ExquisiteCatBread/RatDistortion/README.md

# RatDistortion
Guitar pedal based on Proco RAT

See "Distortion pedal project documentation.pdf"

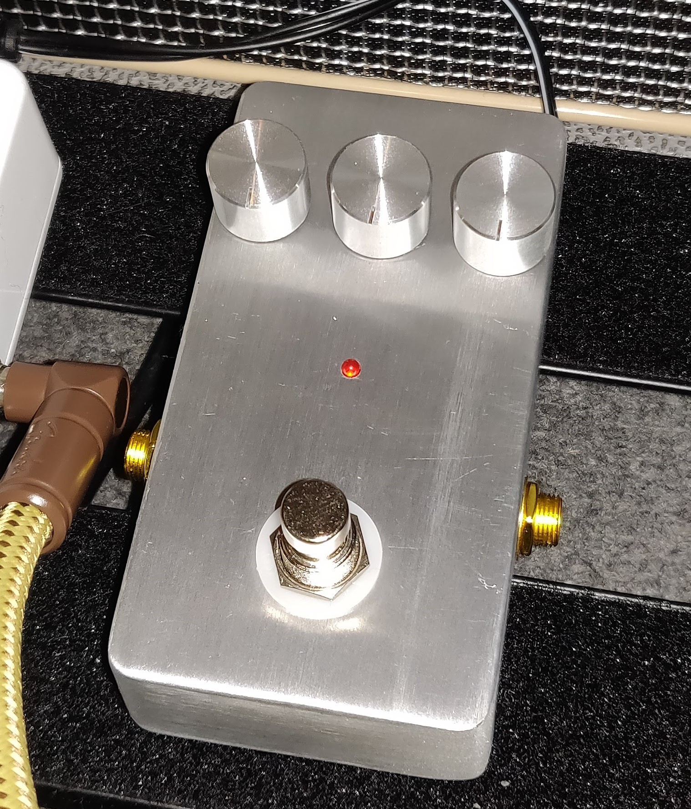
[picture p1: Pictures/Pedal.jpg]
RAT_distortion_pedal
