ExquisiteCatBread/RatDistortion/Pictures/3pdt layout (1).jpg

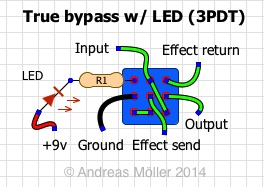
Pictures/3pdt layout (1).jpg
