ExquisiteCatBread/RatDistortion/Pictures/3pdt layout.png

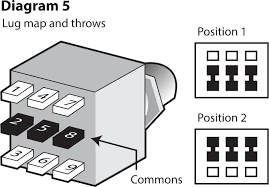
Pictures/3pdt layout.png
