ExquisiteCatBread/RatDistortion/Pictures/Drilling (1).jpg

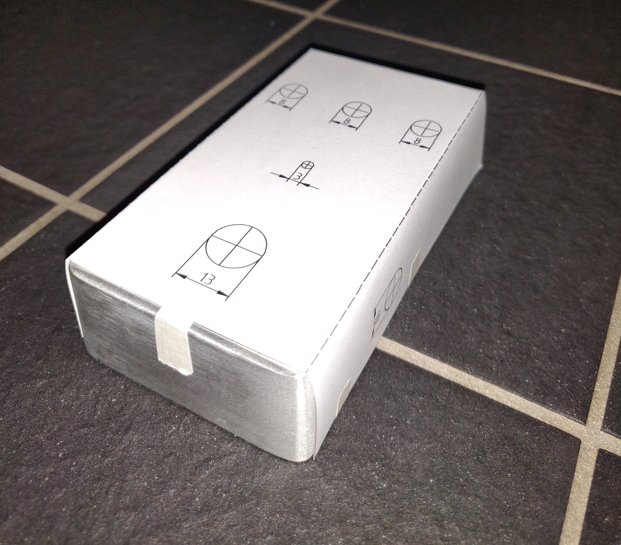
Pictures/Drilling (1).jpg
