ExquisiteCatBread/RatDistortion/Pictures/Drilling (2).jpg

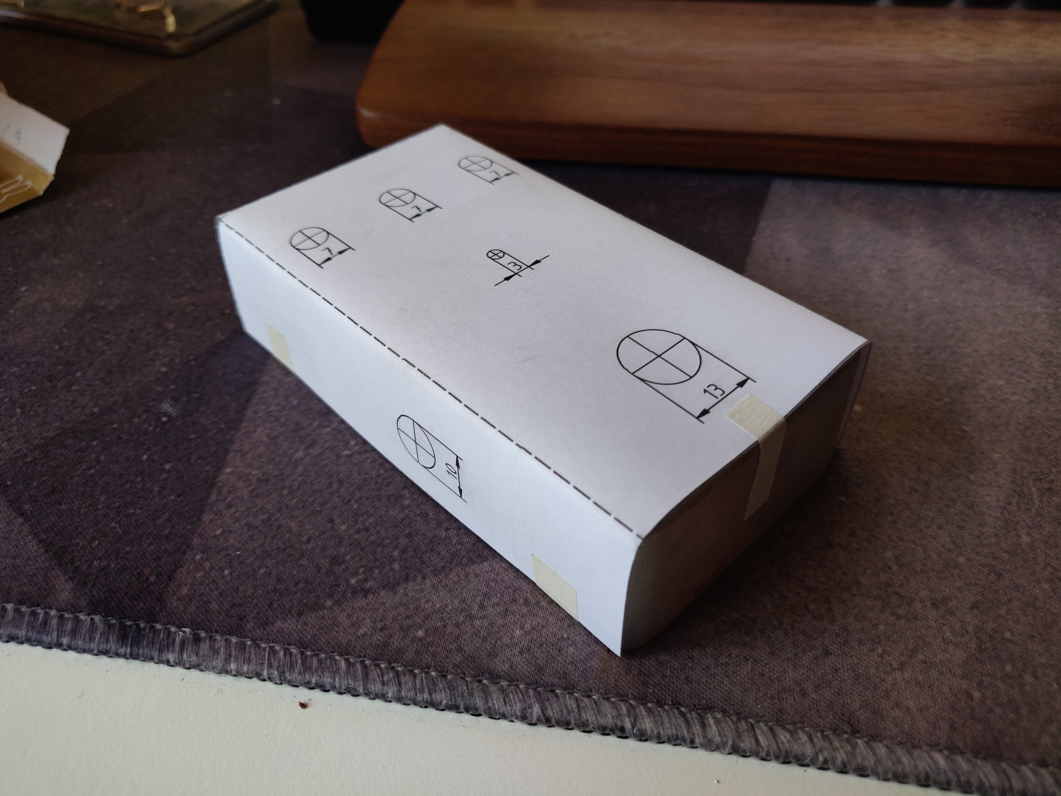
Pictures/Drilling (2).jpg
