ExquisiteCatBread/RatDistortion/Pictures/Drilling (3).jpg

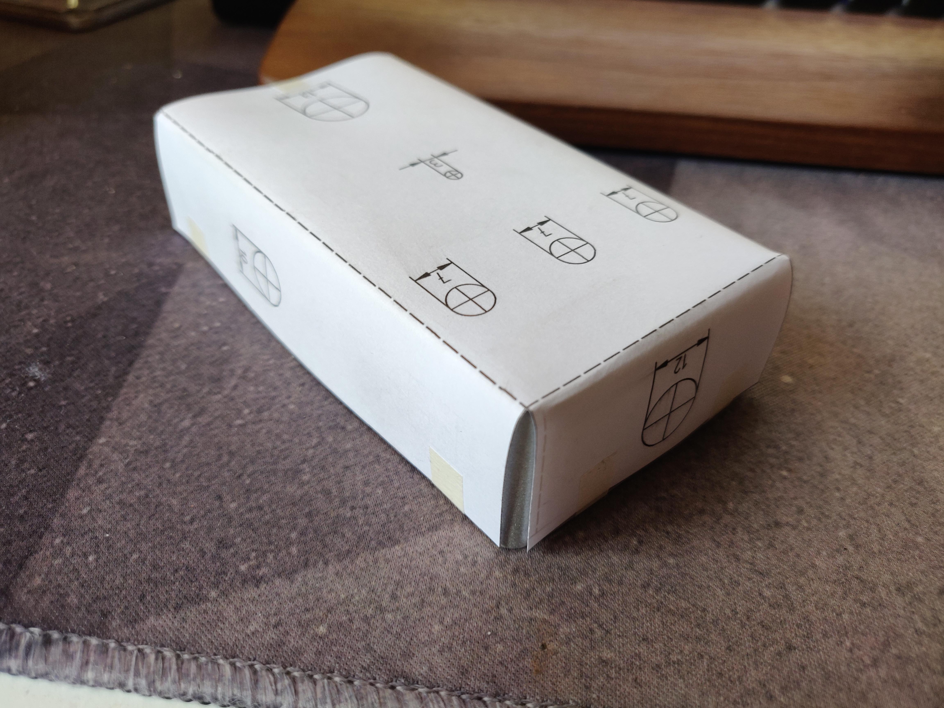
Pictures/Drilling (3).jpg
