ExquisiteCatBread/RatDistortion/Pictures/Drilling (4).jpg

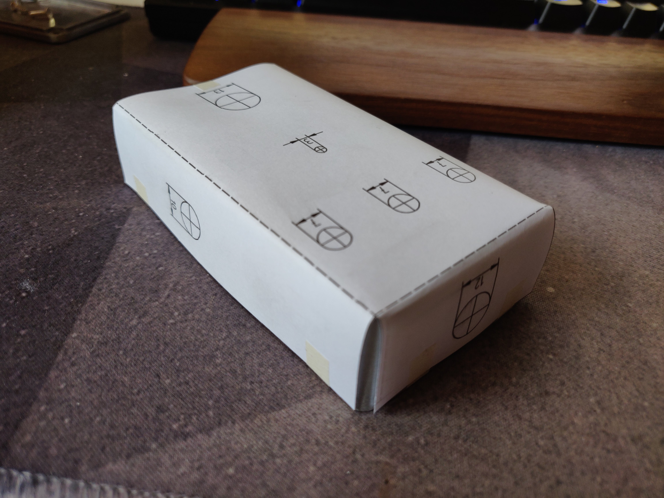
Pictures/Drilling (4).jpg
