ExquisiteCatBread/RatDistortion/Pictures/Drilling (5).jpg

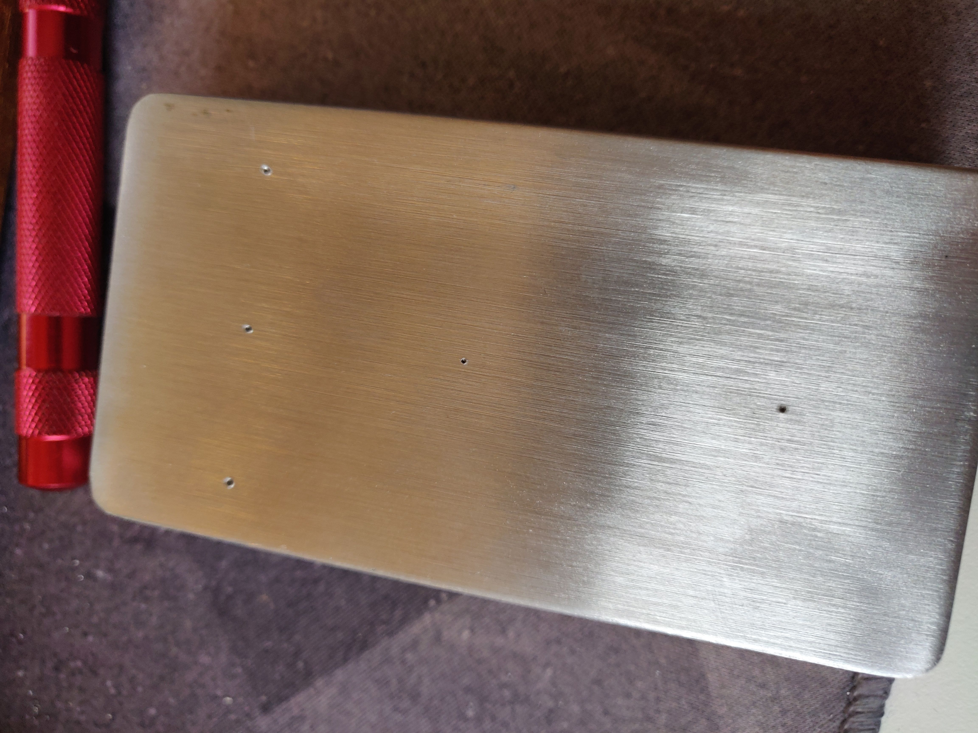
Pictures/Drilling (5).jpg
