ExquisiteCatBread/RatDistortion/Pictures/Drilling (6).jpg

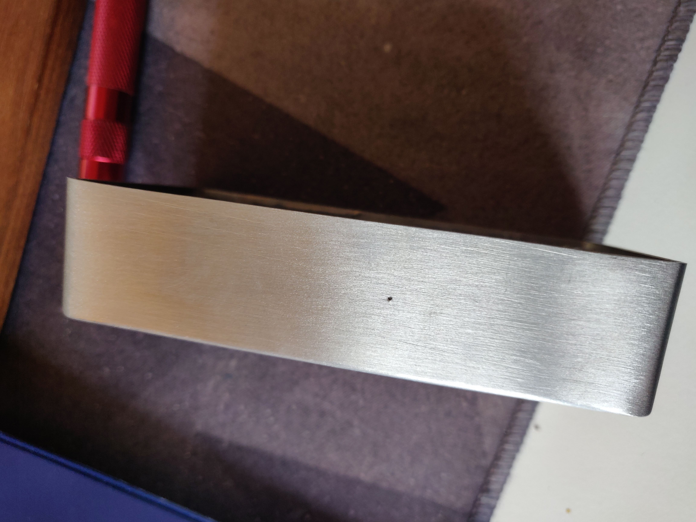
Pictures/Drilling (6).jpg
