ExquisiteCatBread/RatDistortion/Pictures/Drilling (7).jpg

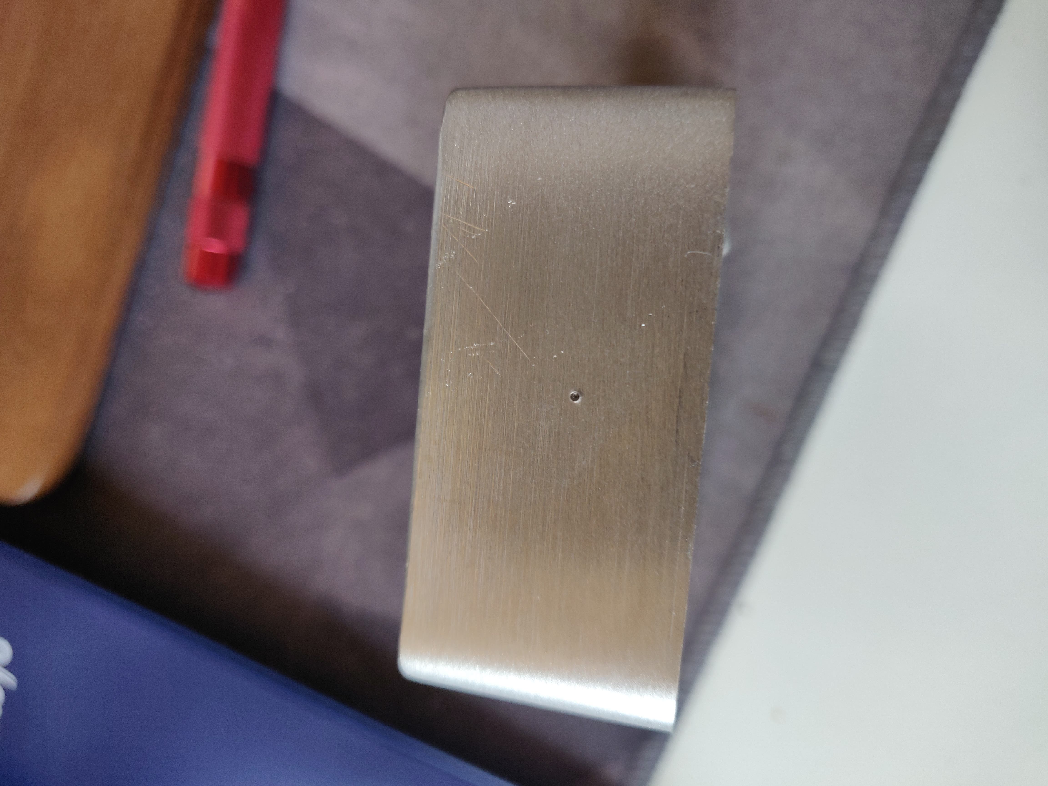
Pictures/Drilling (7).jpg
