ExquisiteCatBread/RatDistortion/Pictures/Drilling (8).jpg

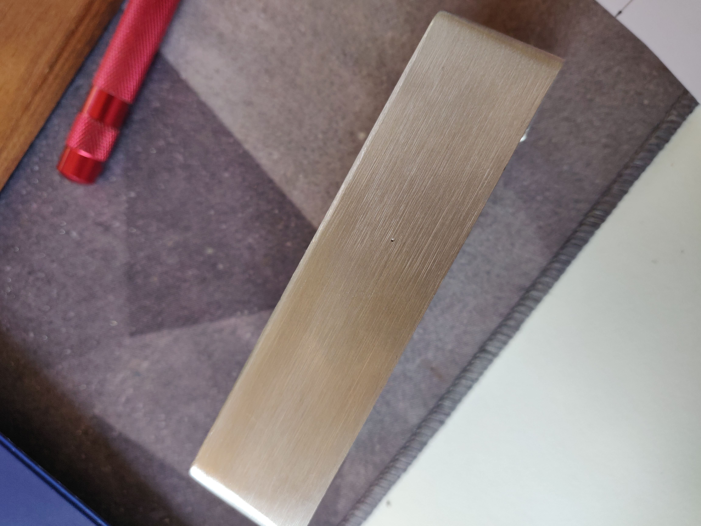
Pictures/Drilling (8).jpg
