ExquisiteCatBread/RatDistortion/Pictures/Drilling (9).jpg

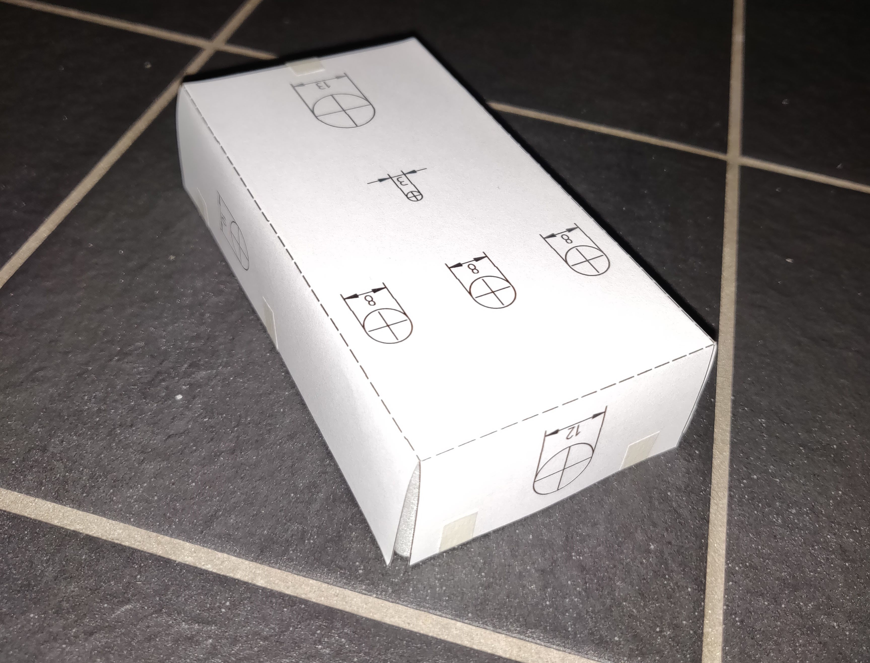
Pictures/Drilling (9).jpg
