ExquisiteCatBread/RatDistortion/Pictures/Drilling (10).jpg

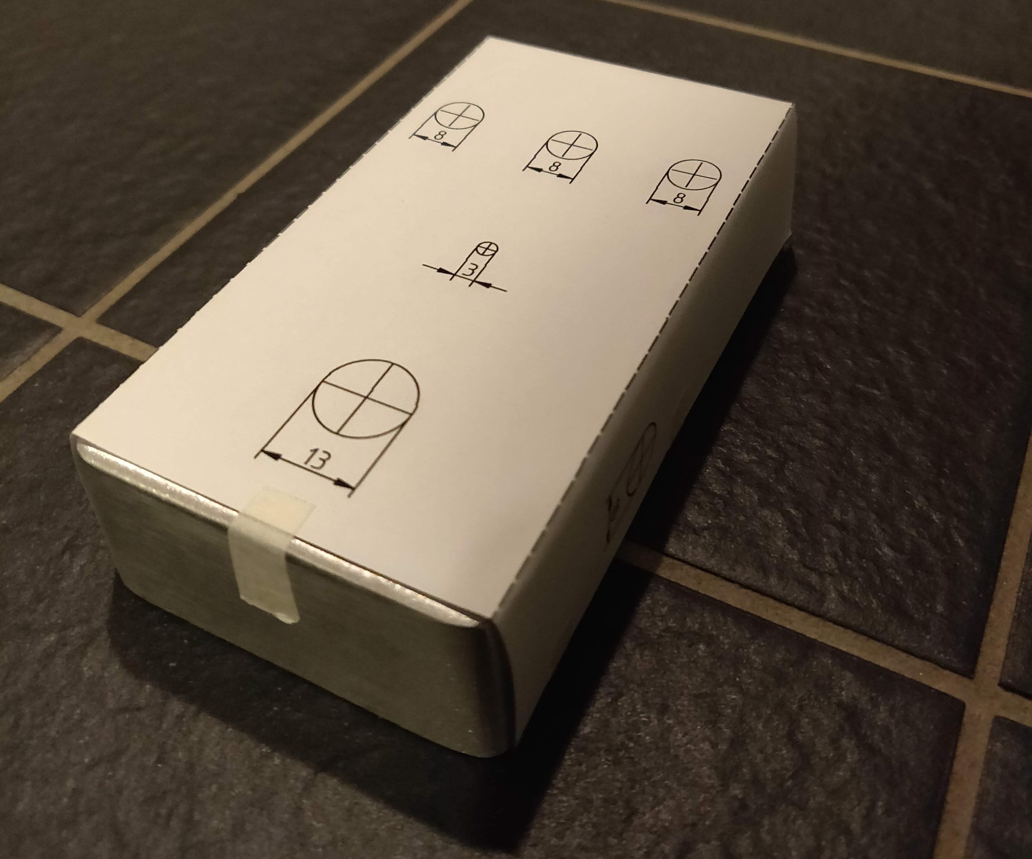
Pictures/Drilling (10).jpg
