ExquisiteCatBread/RatDistortion/Pictures/Drilling (11).jpg

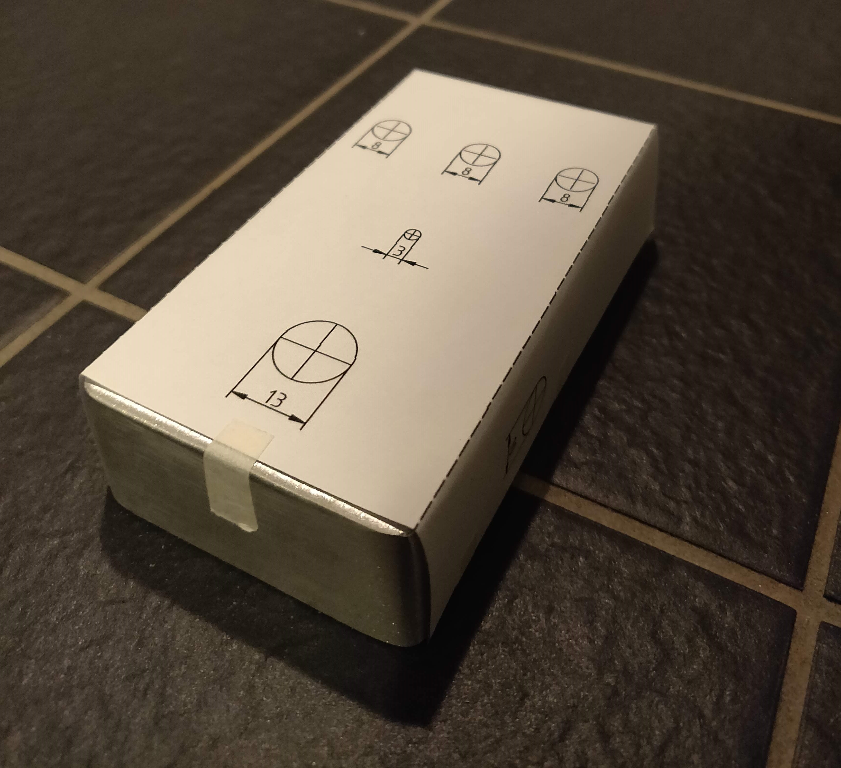
Pictures/Drilling (11).jpg
