ExquisiteCatBread/RatDistortion/Pictures/Fake JFET analysis.jpg

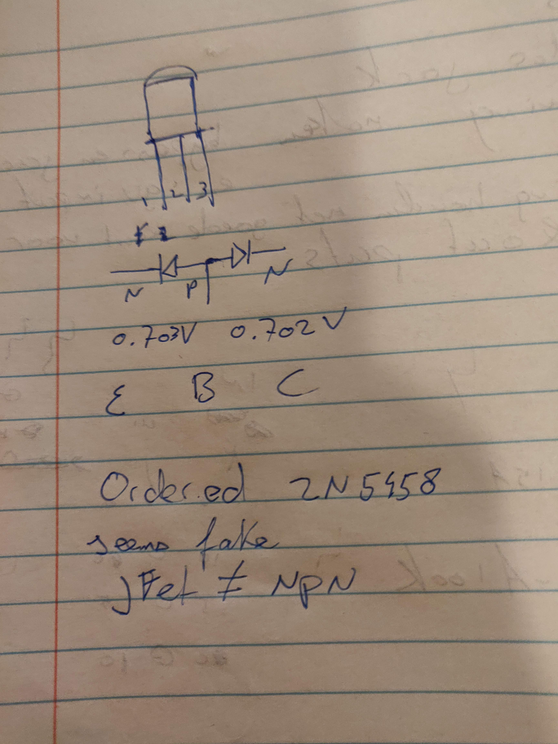
Pictures/Fake JFET analysis.jpg
