ExquisiteCatBread/RatDistortion/Pictures/Inside.jpg

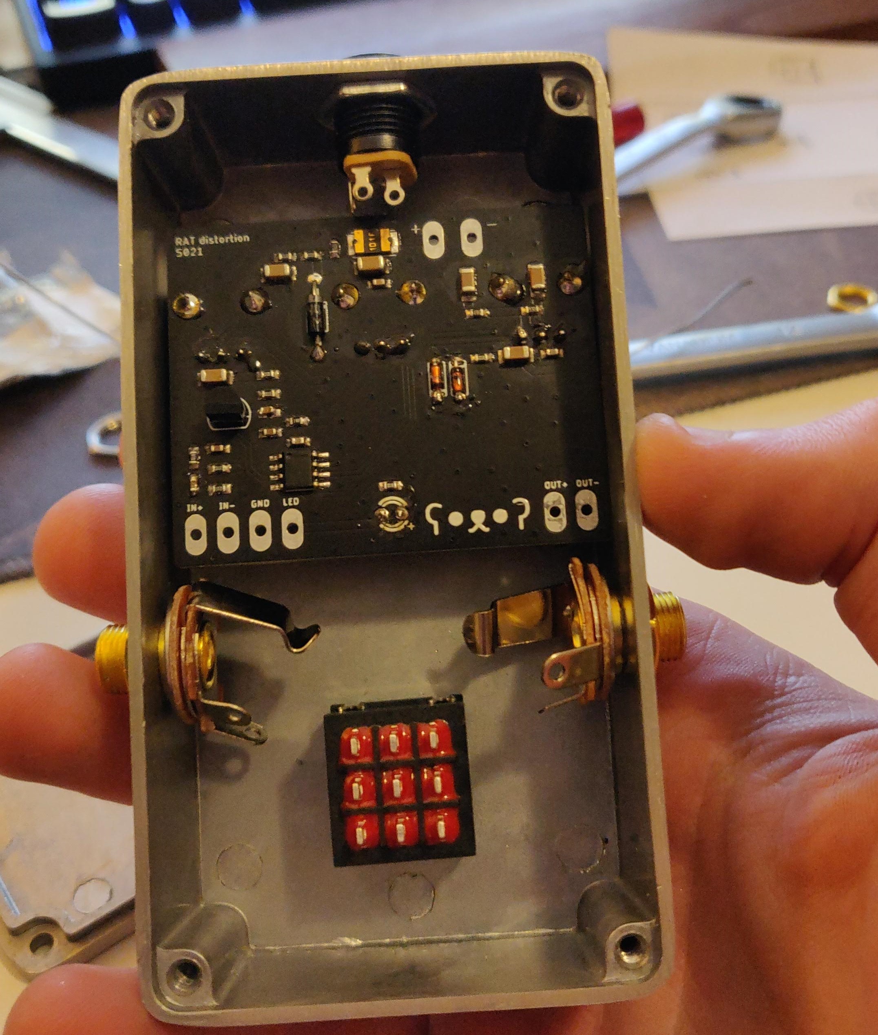
Pictures/Inside.jpg
