ExquisiteCatBread/RatDistortion/Pictures/Laser engraving (1).jpg

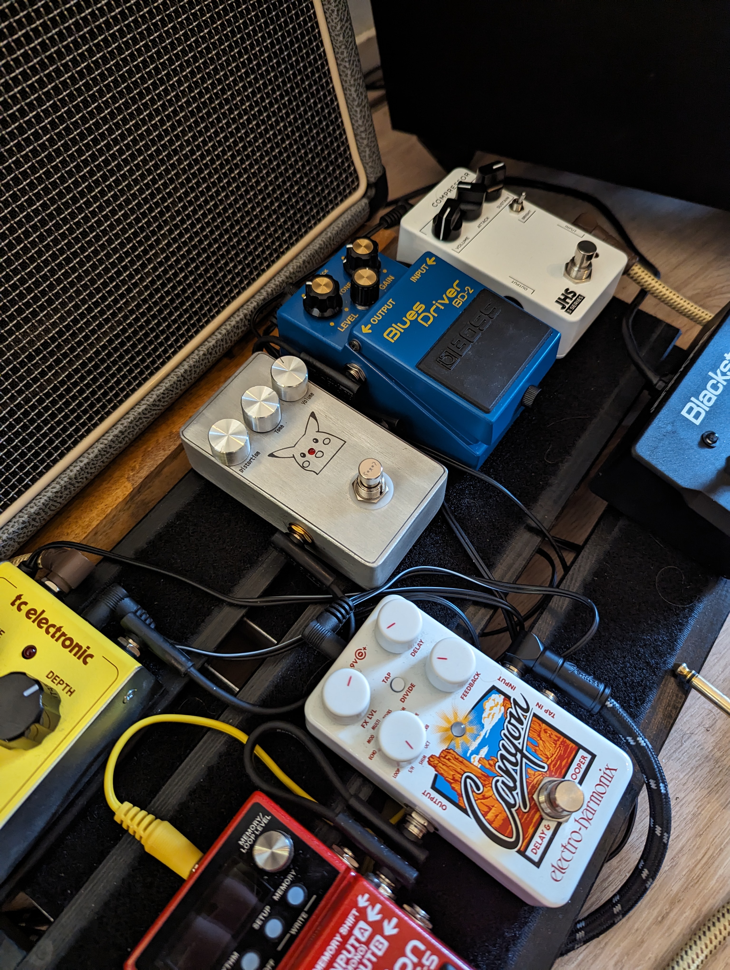
Pictures/Laser engraving (1).jpg
