ExquisiteCatBread/RatDistortion/Pictures/Laser engraving (2).jpg

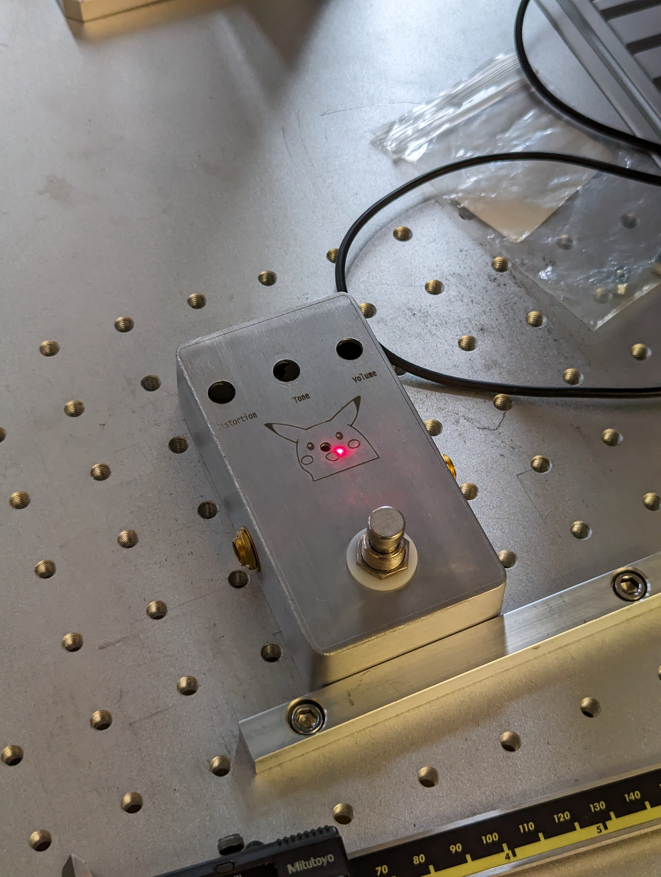
Pictures/Laser engraving (2).jpg
