ExquisiteCatBread/RatDistortion/Pictures/Laser engraving (3).jpg

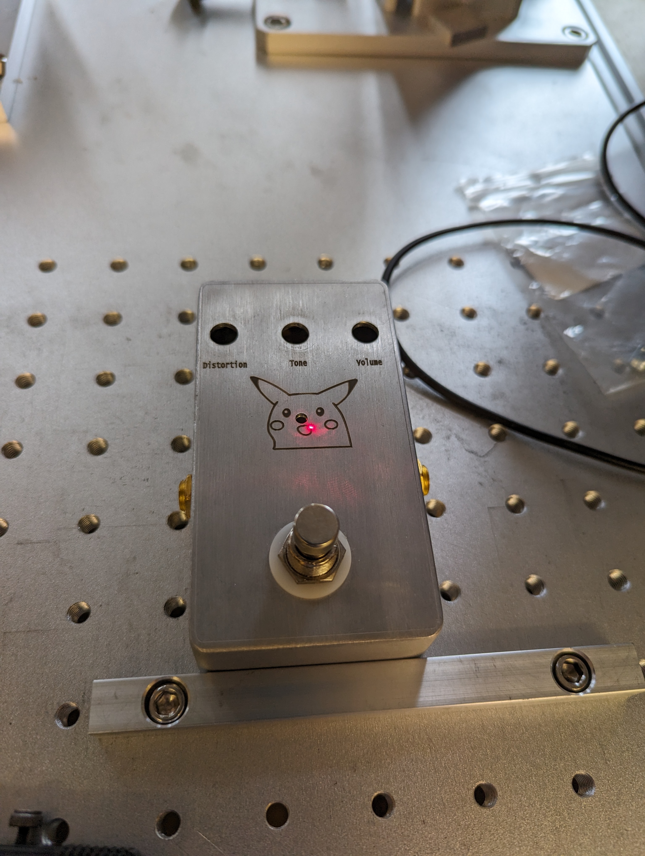
Pictures/Laser engraving (3).jpg
