ExquisiteCatBread/RatDistortion/Pictures/Laser engraving (4).jpg

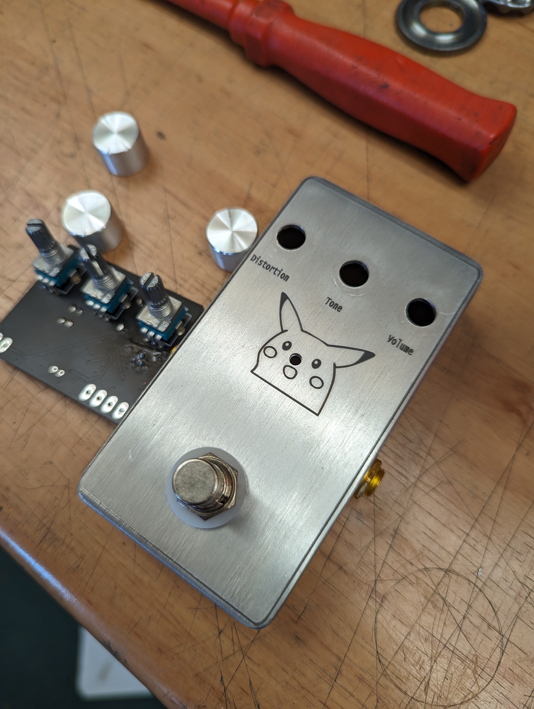
Pictures/Laser engraving (4).jpg
