ExquisiteCatBread/RatDistortion/Pictures/Laser engraving (5).jpg

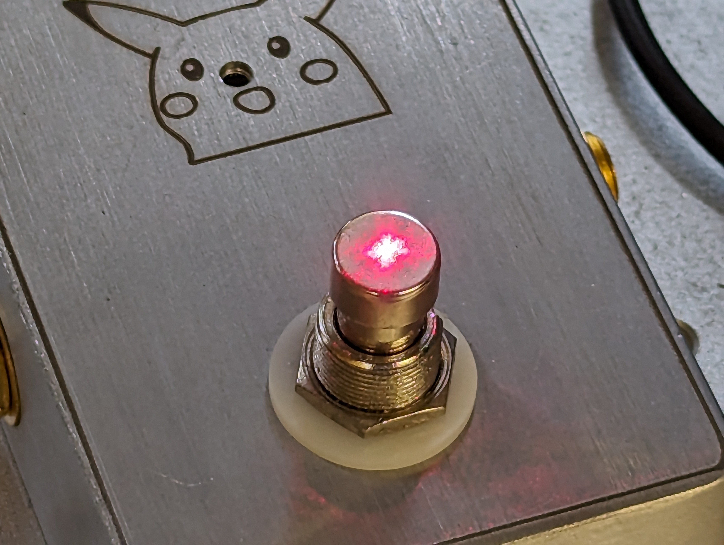
Pictures/Laser engraving (5).jpg
