ExquisiteCatBread/RatDistortion/Pictures/Laser engraving (6).jpg

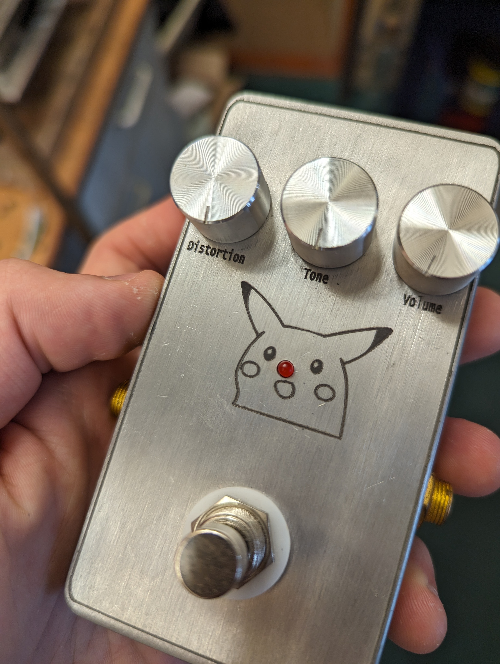
Pictures/Laser engraving (6).jpg
