ExquisiteCatBread/RatDistortion/Pictures/Laser engraving (7).jpg

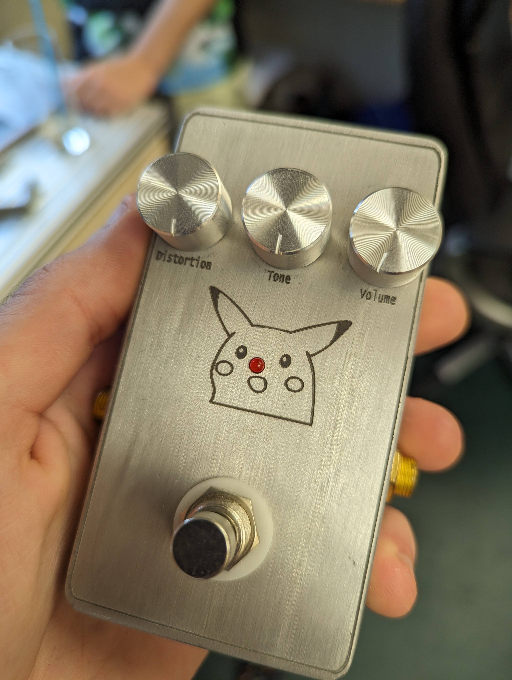
Pictures/Laser engraving (7).jpg
