ExquisiteCatBread/RatDistortion/Pictures/Laser engraving (8).jpg

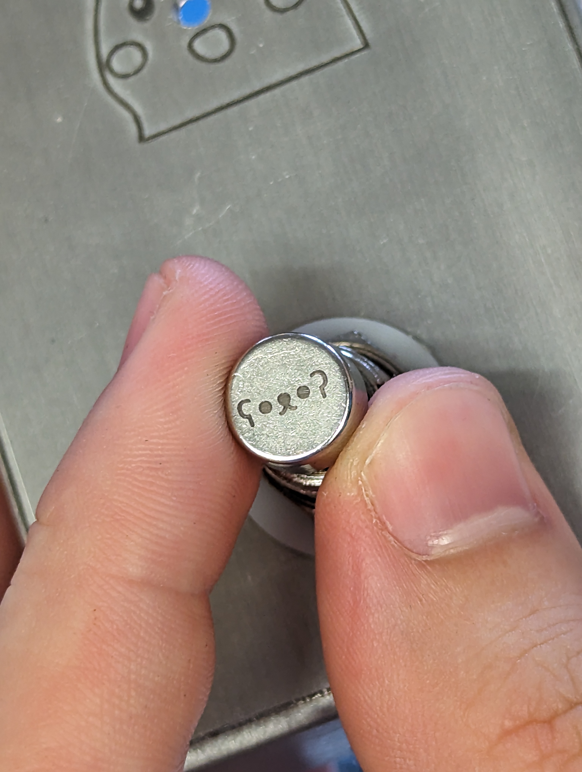
Pictures/Laser engraving (8).jpg
