ExquisiteCatBread/RatDistortion/Pictures/Laser engraving (9).jpg

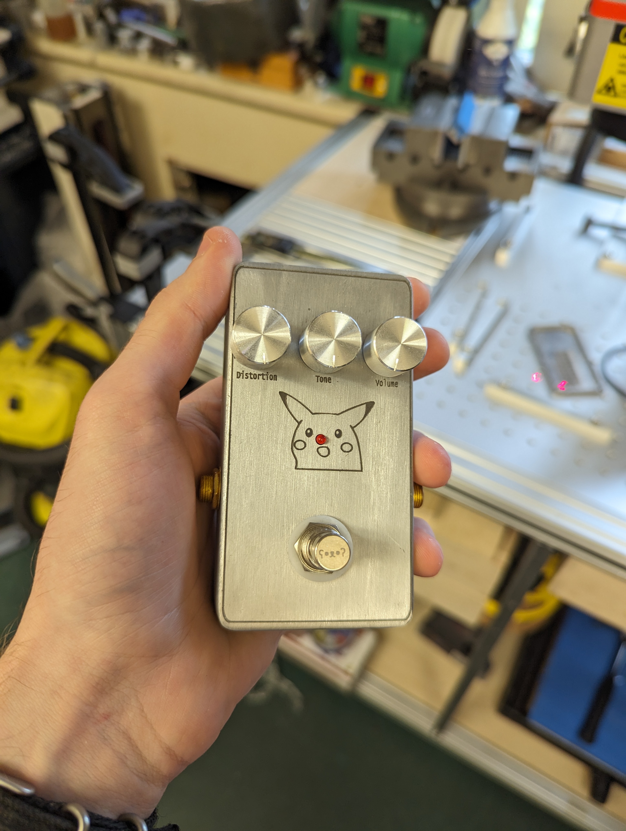
Pictures/Laser engraving (9).jpg
