ExquisiteCatBread/RatDistortion/Pictures/Laser engraving (10).jpg

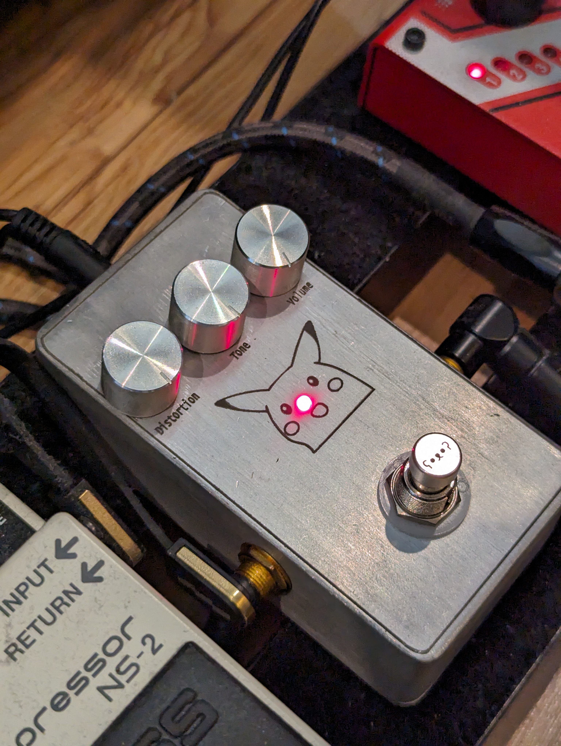
Pictures/Laser engraving (10).jpg
