ExquisiteCatBread/RatDistortion/Pictures/Laser engraving (11).jpg

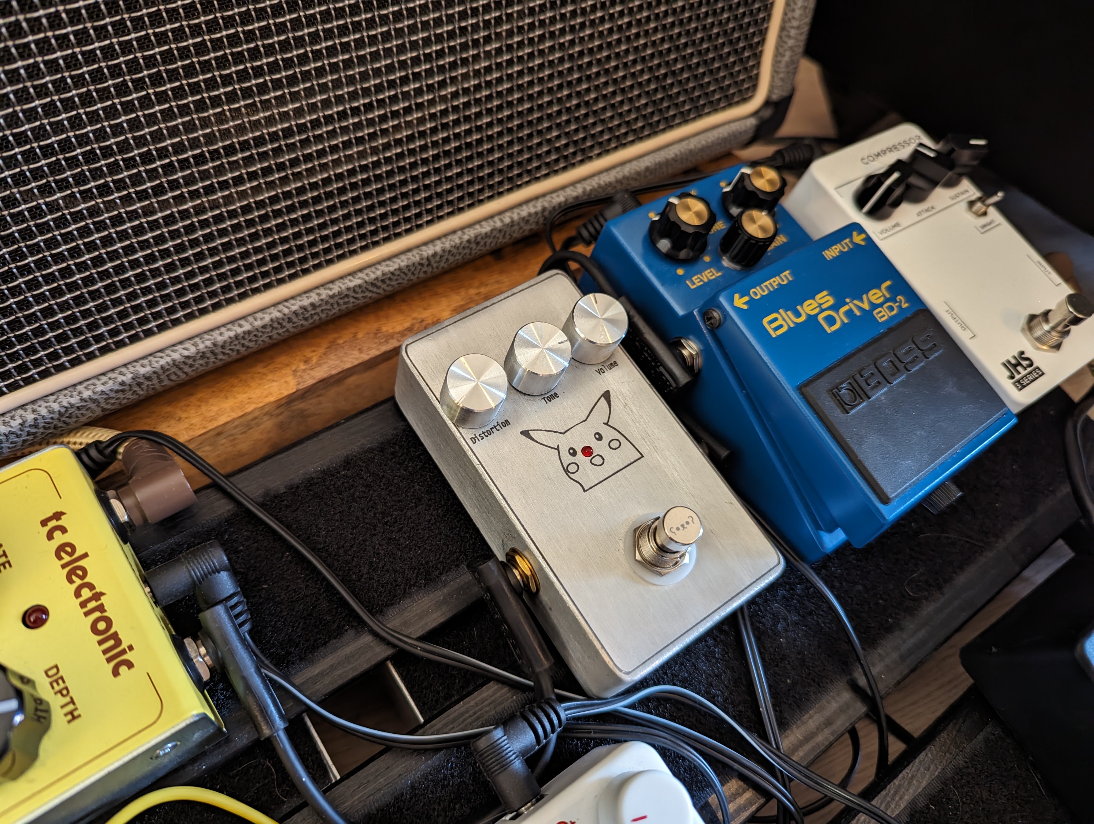
Pictures/Laser engraving (11).jpg
