ExquisiteCatBread/RatDistortion/Pictures/PCB (1).jpg

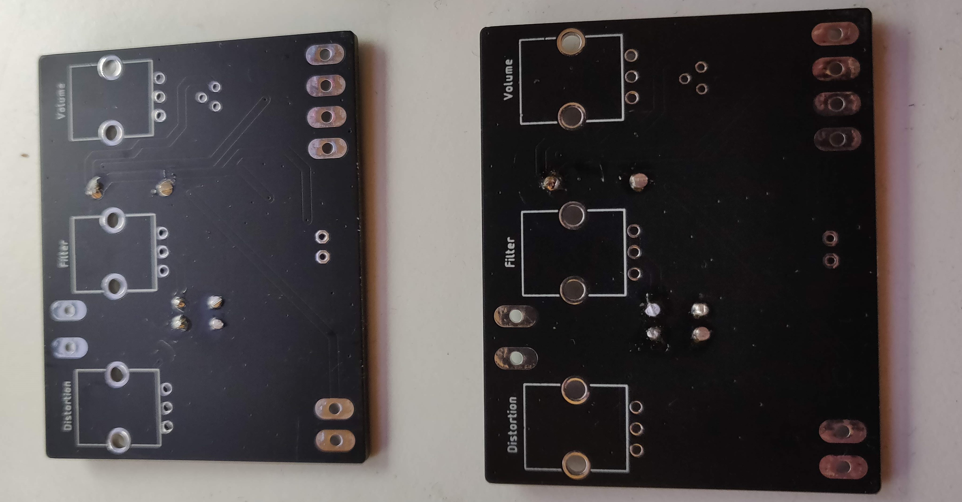
Pictures/PCB (1).jpg
