ExquisiteCatBread/RatDistortion/Pictures/PCB (2).jpg

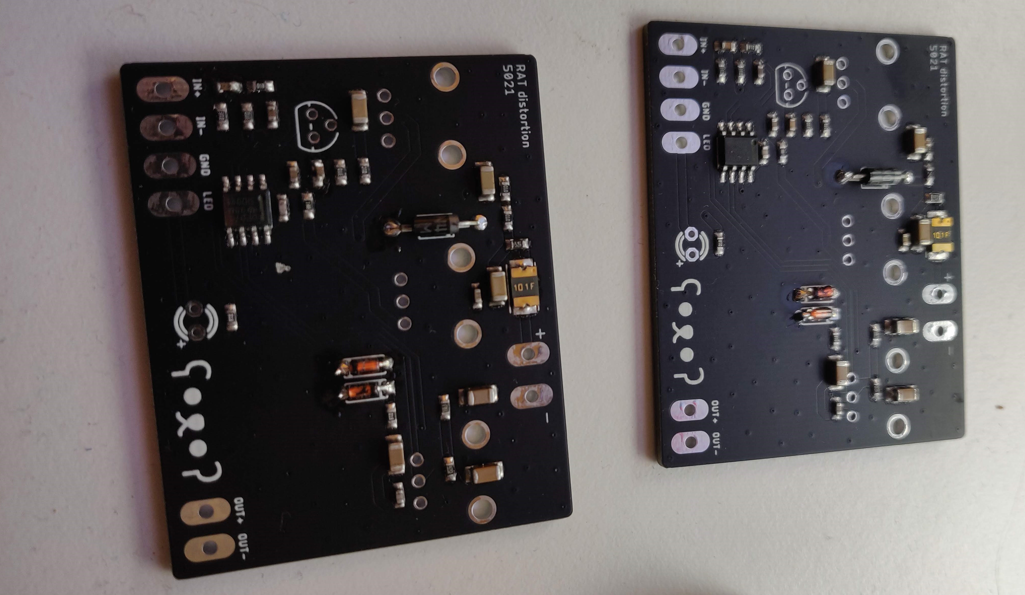
Pictures/PCB (2).jpg
