ExquisiteCatBread/RatDistortion/Pictures/Pedal (1).jpg

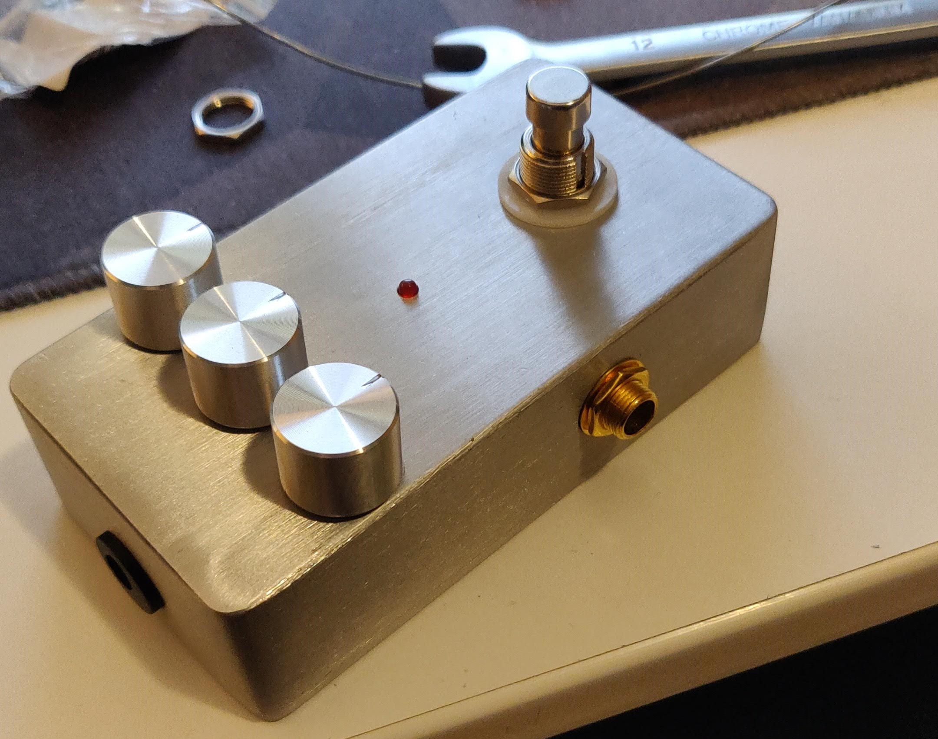
Pictures/Pedal (1).jpg
