ExquisiteCatBread/RatDistortion/Pictures/Pedal (3).jpg

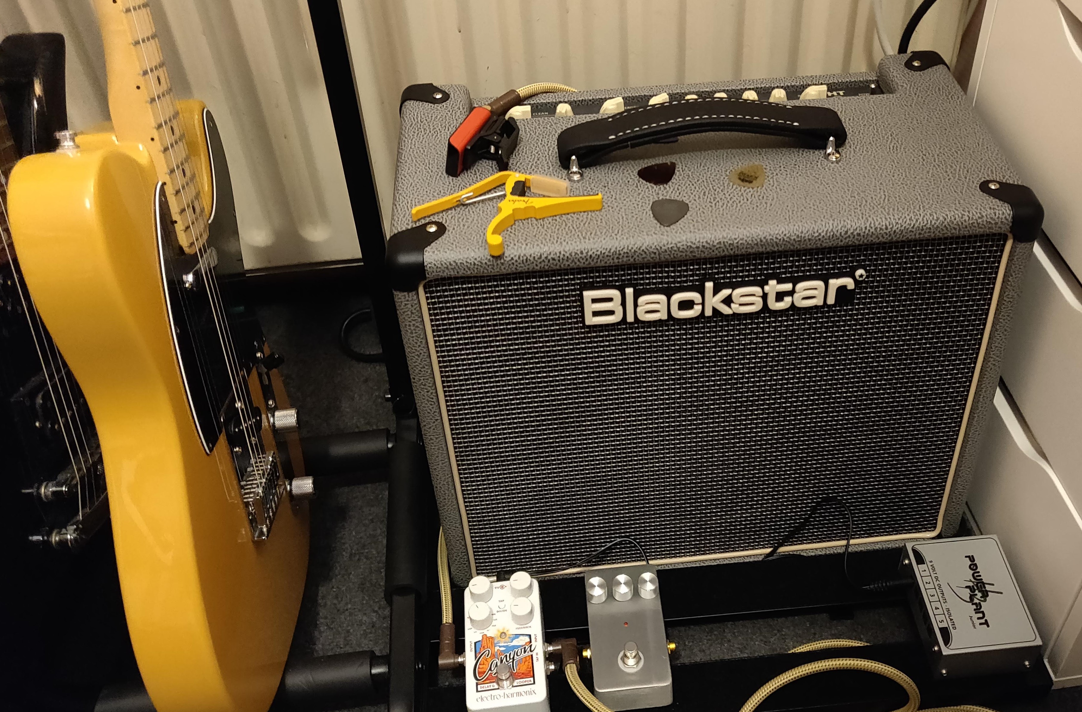
Pictures/Pedal (3).jpg
