ExquisiteCatBread/RatDistortion/Pictures/Pedal (4).jpg

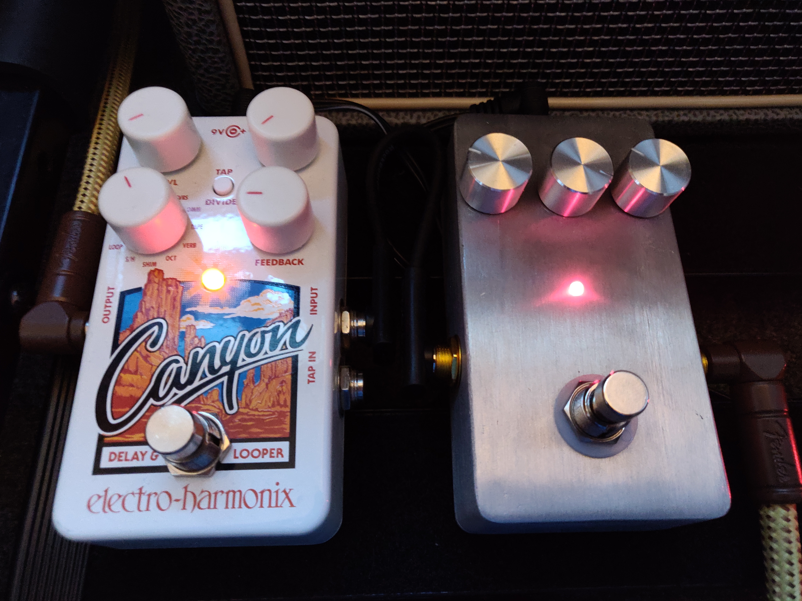
Pictures/Pedal (4).jpg
