ExquisiteCatBread/RatDistortion/Pictures/Pedal (5).jpg

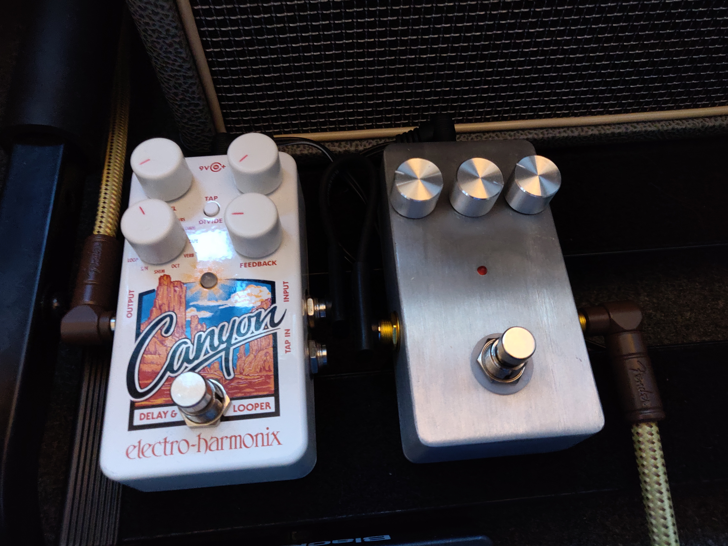
Pictures/Pedal (5).jpg
