ExquisiteCatBread/RatDistortion/Pictures/Used equipment.jpg

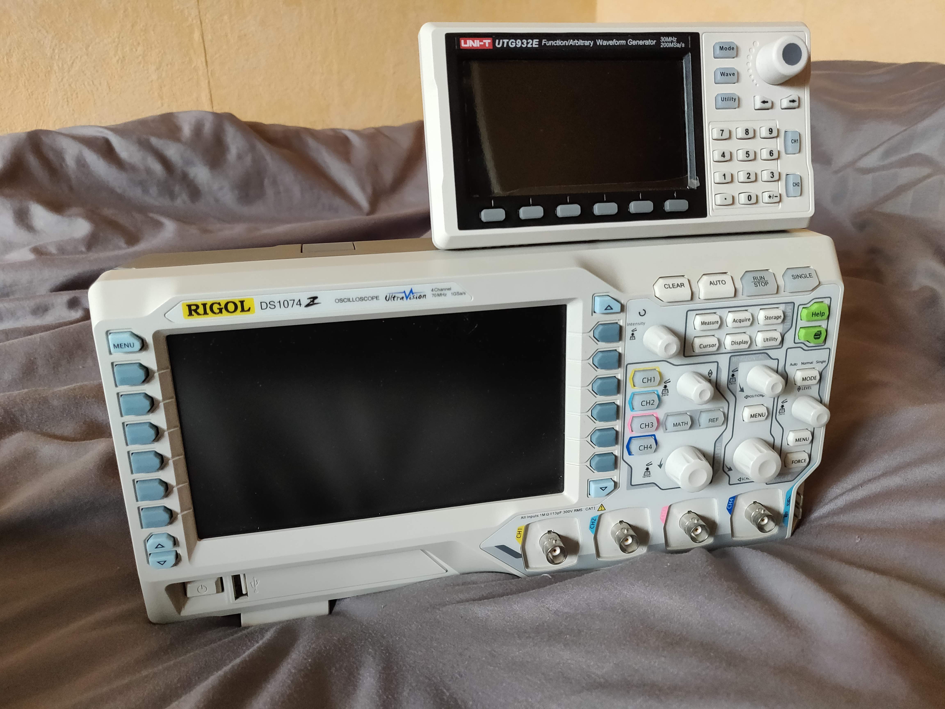
Pictures/Used equipment.jpg
