ExquisiteCatBread/RatDistortion/Drill template/RAT distortion drill template.dxf

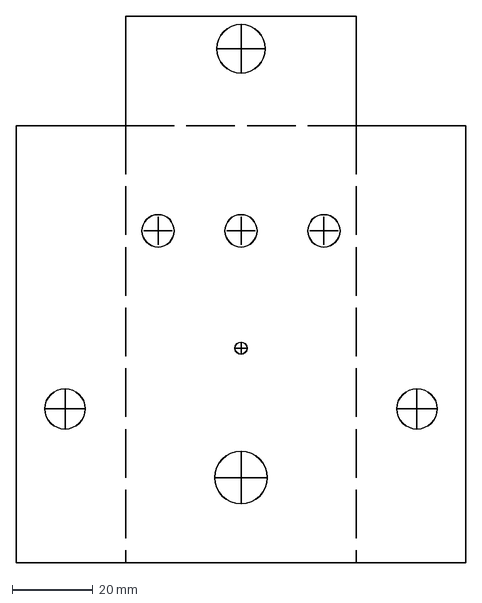
[picture p47: CAD file, 2021-12-30]
Drill template/RAT distortion drill template.dxf
111.0 x 135.0 mm
