ExquisiteCatBread/RatDistortion/Wiring PCB inside housing/Wires.png

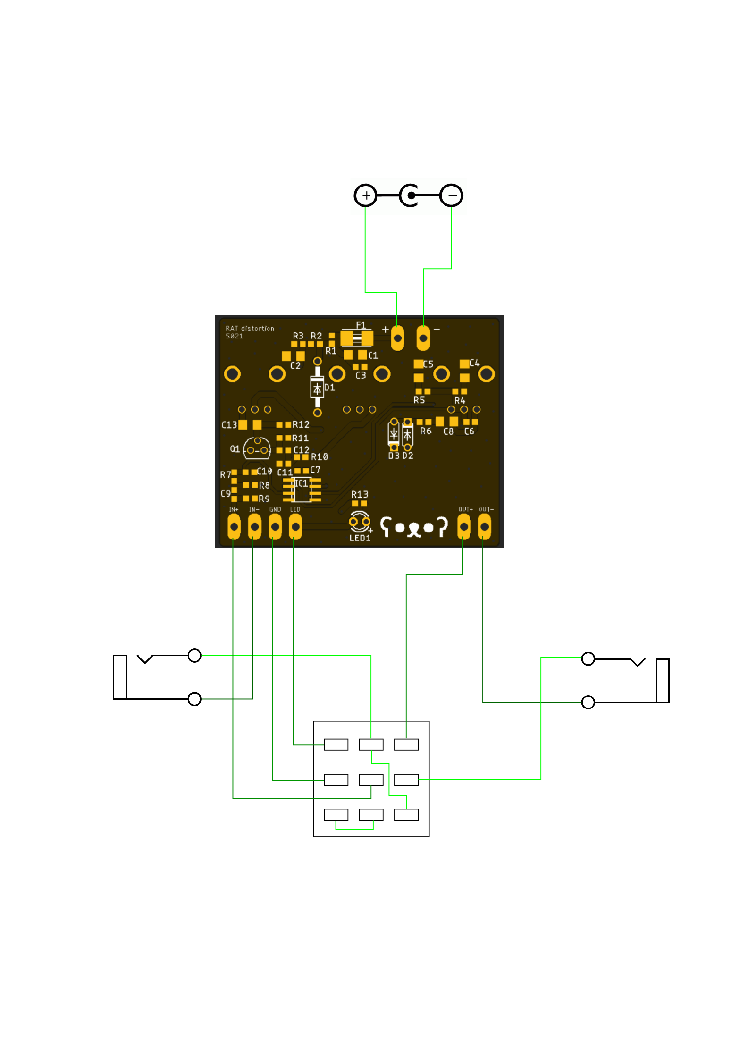
Wiring PCB inside housing/Wires.png
