ExquisiteCatBread/RatDistortion/Pictures/Testing/Filter 0p scope no load.png

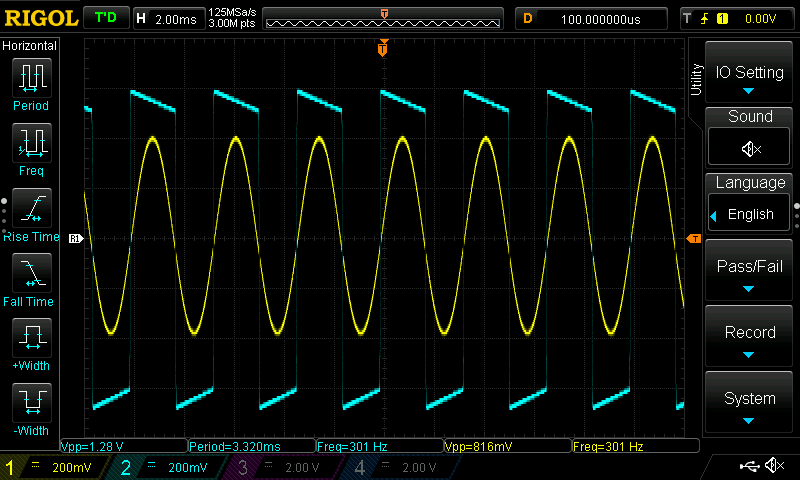
Pictures/Testing/Filter 0p scope no load.png
