ExquisiteCatBread/RatDistortion/Pictures/Testing/Filter 0p.JPG

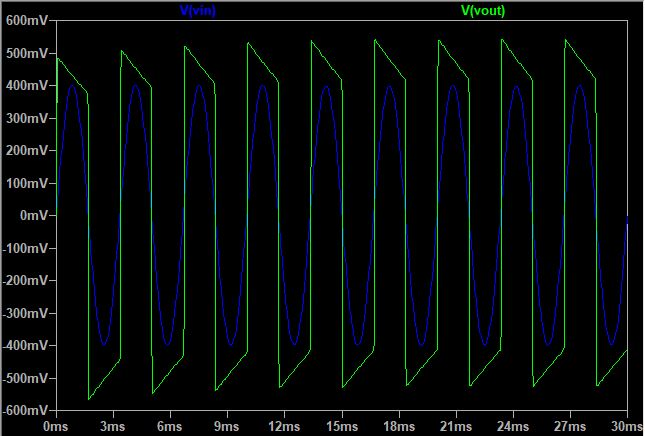
Pictures/Testing/Filter 0p.JPG
