ExquisiteCatBread/RatDistortion/Pictures/Testing/Filter 50p scope no load.png

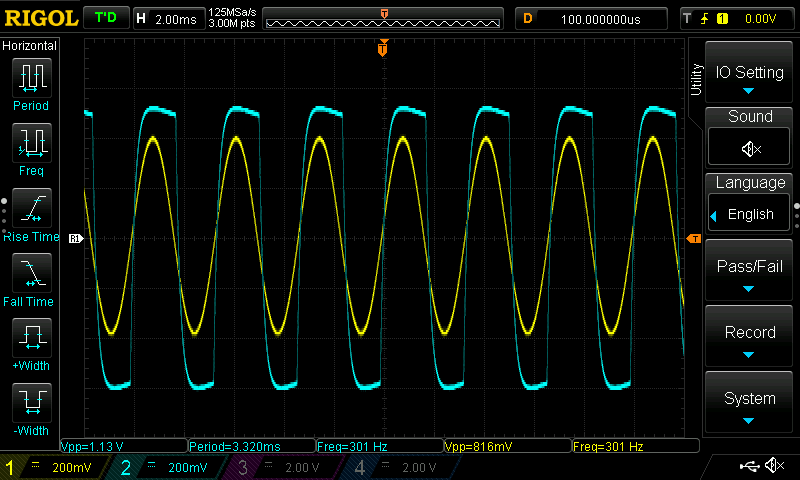
Pictures/Testing/Filter 50p scope no load.png
