ExquisiteCatBread/RatDistortion/Pictures/Testing/Filter 50p.JPG

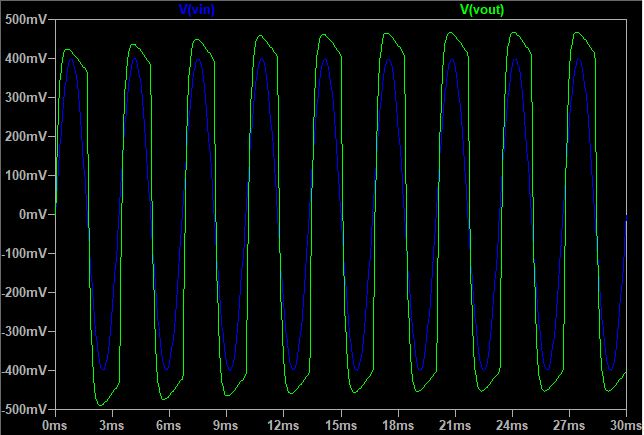
Pictures/Testing/Filter 50p.JPG
