ExquisiteCatBread/RatDistortion/Pictures/Testing/Filter 100p scope no load.png

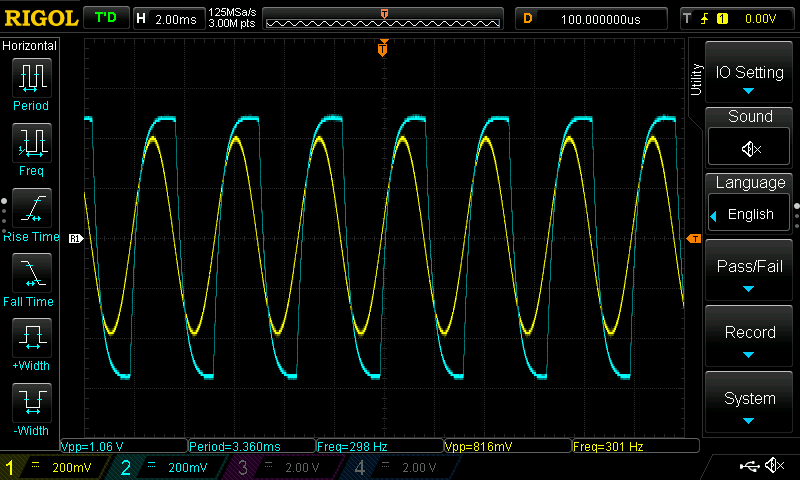
Pictures/Testing/Filter 100p scope no load.png
