ExquisiteCatBread/RatDistortion/Pictures/Testing/Filter 100p scope.png

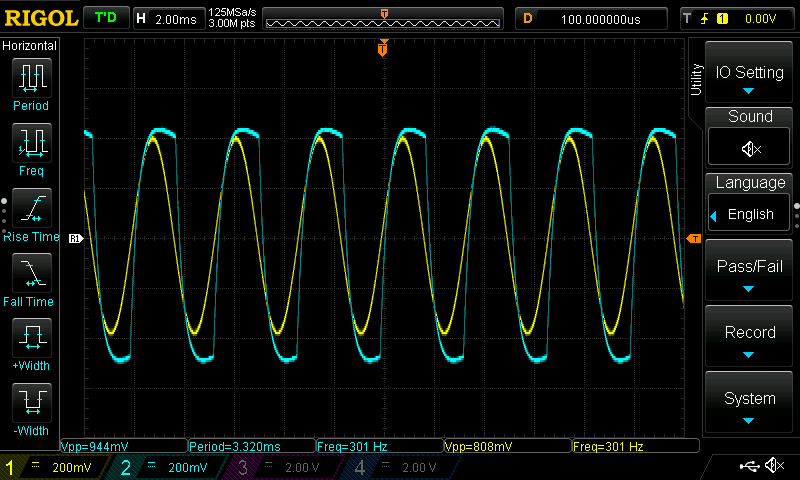
Pictures/Testing/Filter 100p scope.png
