ExquisiteCatBread/RatDistortion/Pictures/Testing/Filter 100p.JPG

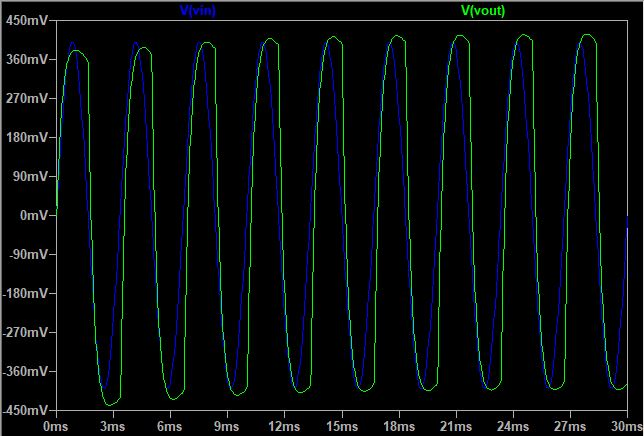
Pictures/Testing/Filter 100p.JPG
