ExquisiteCatBread/RatDistortion/Pictures/Testing/High dis 80hz scope no load.png

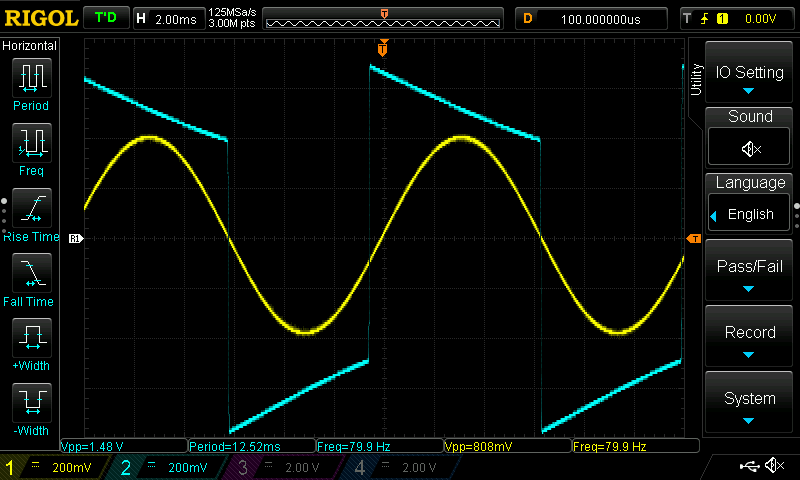
Pictures/Testing/High dis 80hz scope no load.png
