ExquisiteCatBread/RatDistortion/Pictures/Testing/High dis 80hz scope.png

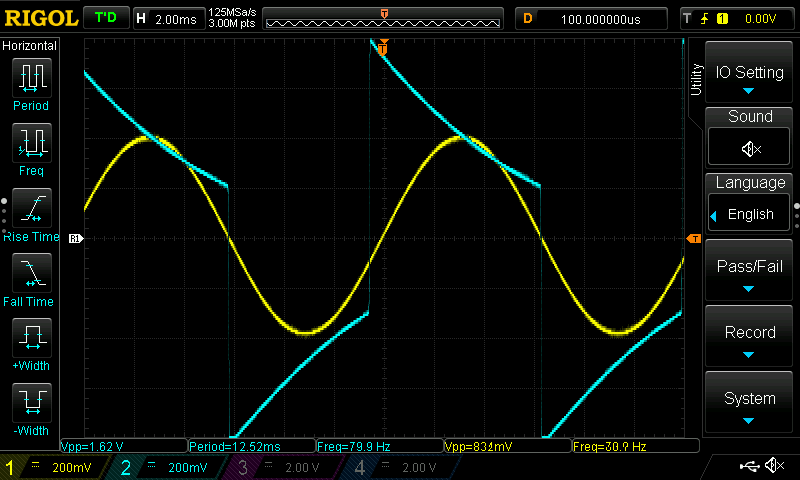
Pictures/Testing/High dis 80hz scope.png
