ExquisiteCatBread/RatDistortion/Pictures/Testing/High dis 80hz.JPG

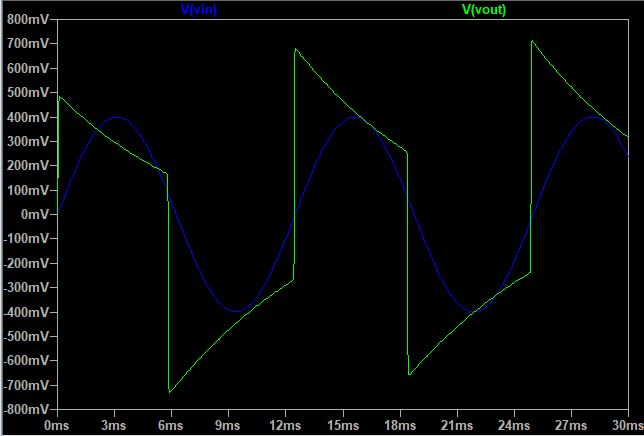
Pictures/Testing/High dis 80hz.JPG
