ExquisiteCatBread/RatDistortion/Pictures/Testing/High dis 300hz.JPG

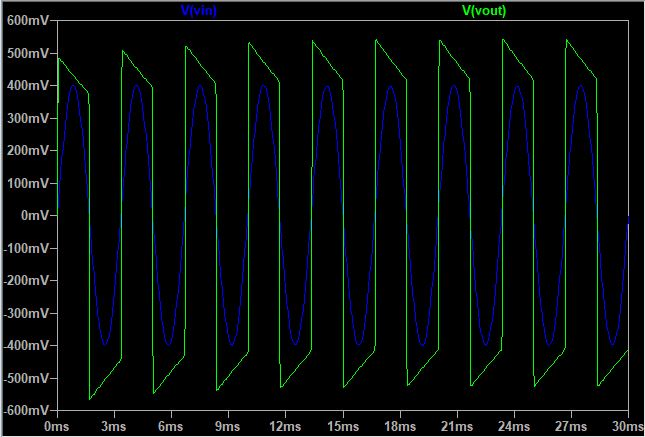
Pictures/Testing/High dis 300hz.JPG
