ExquisiteCatBread/RatDistortion/Pictures/Testing/Low dis 80hz scope no load.png

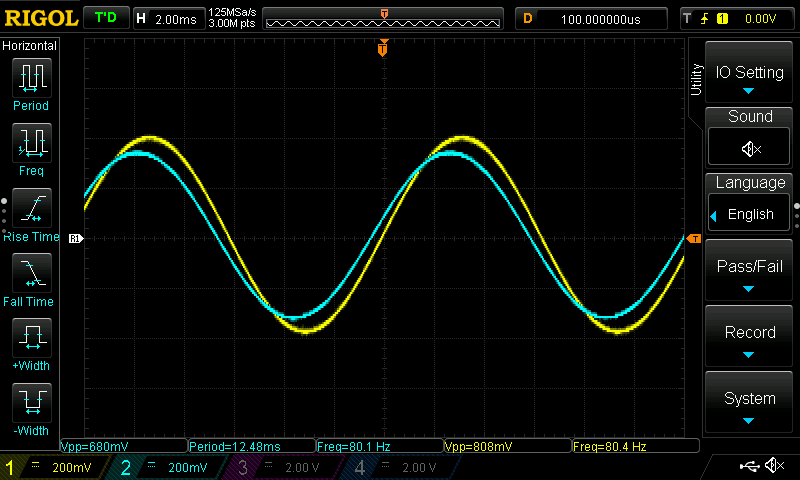
Pictures/Testing/Low dis 80hz scope no load.png
