ExquisiteCatBread/RatDistortion/Pictures/Testing/Low dis 80hz.JPG

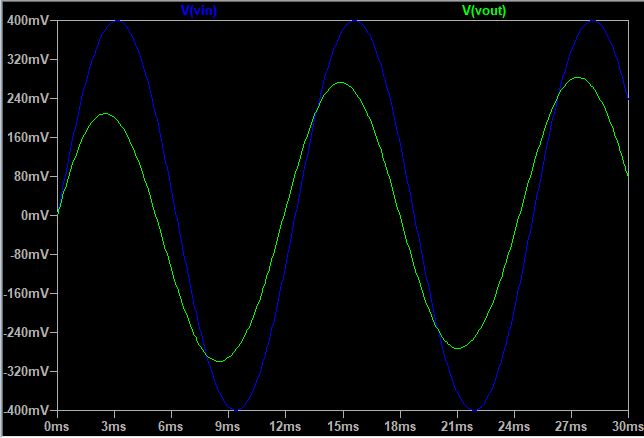
Pictures/Testing/Low dis 80hz.JPG
