ExquisiteCatBread/RatDistortion/Pictures/Testing/Low dis 300hz scope no load.png

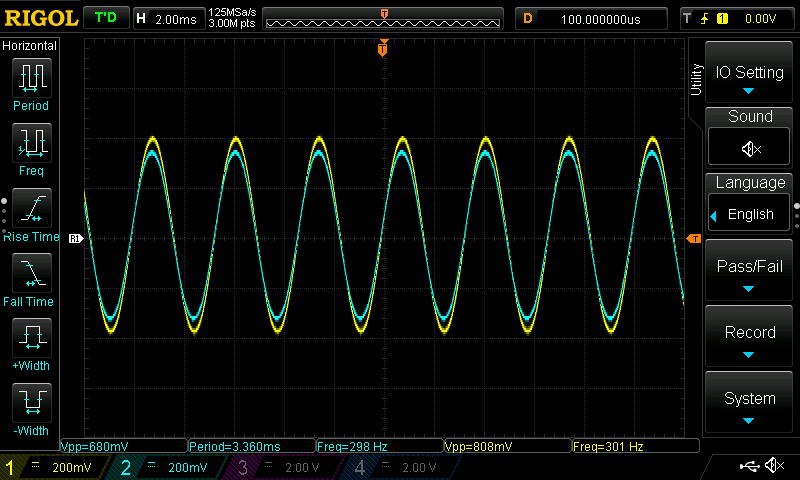
Pictures/Testing/Low dis 300hz scope no load.png
