ExquisiteCatBread/RatDistortion/Pictures/Testing/Low dis 300hz.JPG

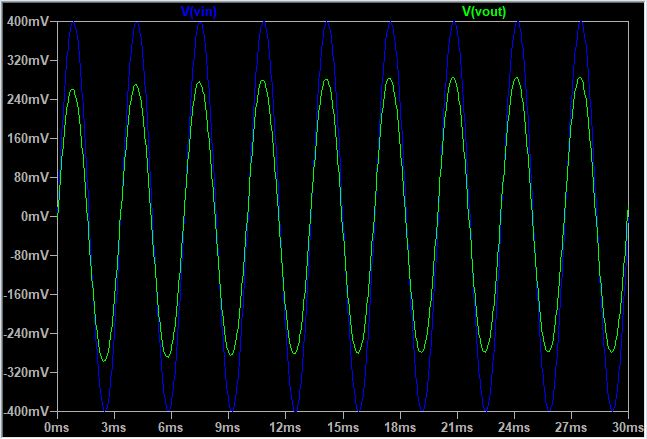
Pictures/Testing/Low dis 300hz.JPG
