ExquisiteCatBread/RatDistortion/Pictures/Testing/Vol 0p scope no load.png

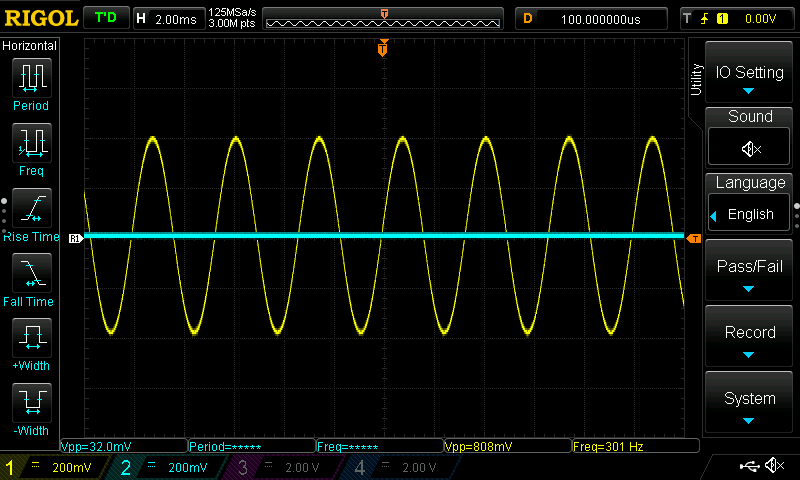
Pictures/Testing/Vol 0p scope no load.png
