ExquisiteCatBread/RatDistortion/Pictures/Testing/Vol 0p scope.png

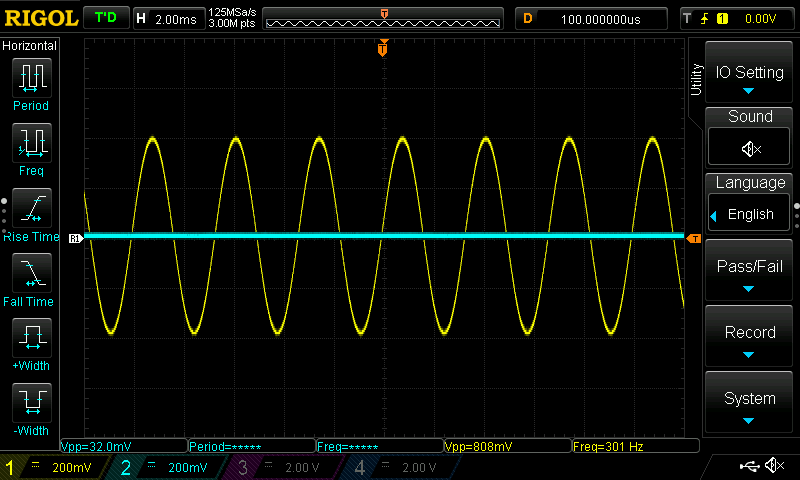
Pictures/Testing/Vol 0p scope.png
