ExquisiteCatBread/RatDistortion/Pictures/Testing/Vol 0p.JPG

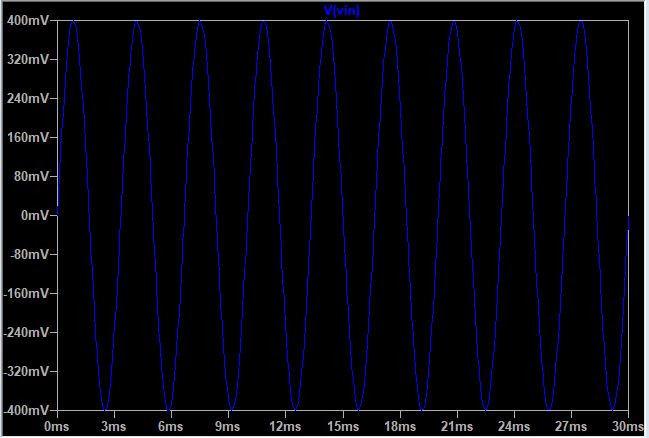
Pictures/Testing/Vol 0p.JPG
