ExquisiteCatBread/RatDistortion/Pictures/Testing/Vol 50p scope no load.png

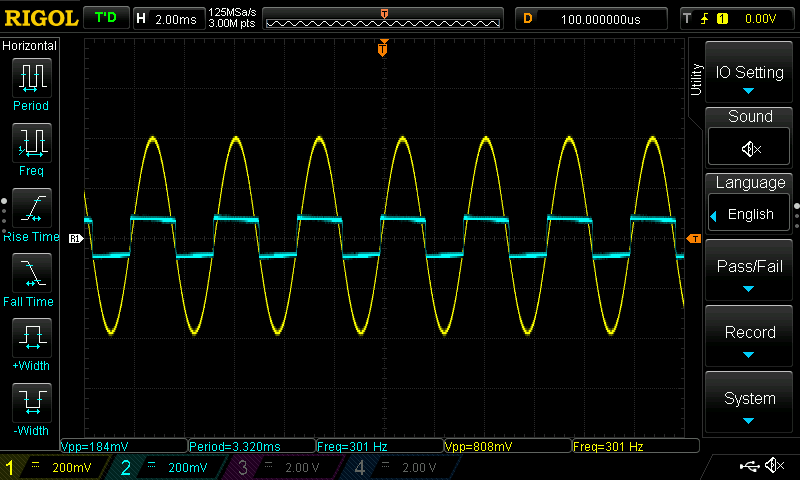
Pictures/Testing/Vol 50p scope no load.png
