ExquisiteCatBread/RatDistortion/Pictures/Testing/Vol 50p.JPG

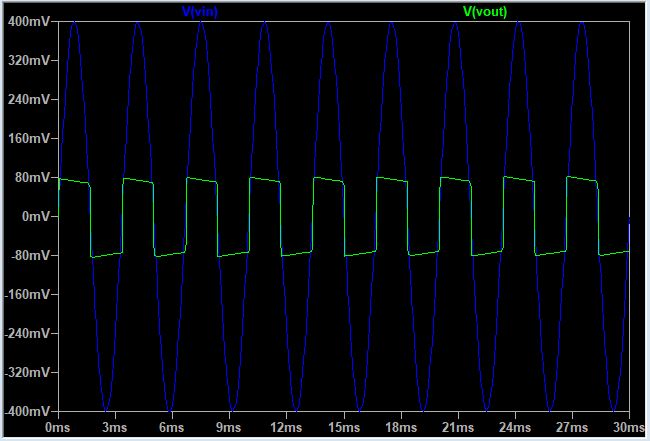
Pictures/Testing/Vol 50p.JPG
