ExquisiteCatBread/RatDistortion/Drill template/RAT distortion drill template no dimensions.pdf

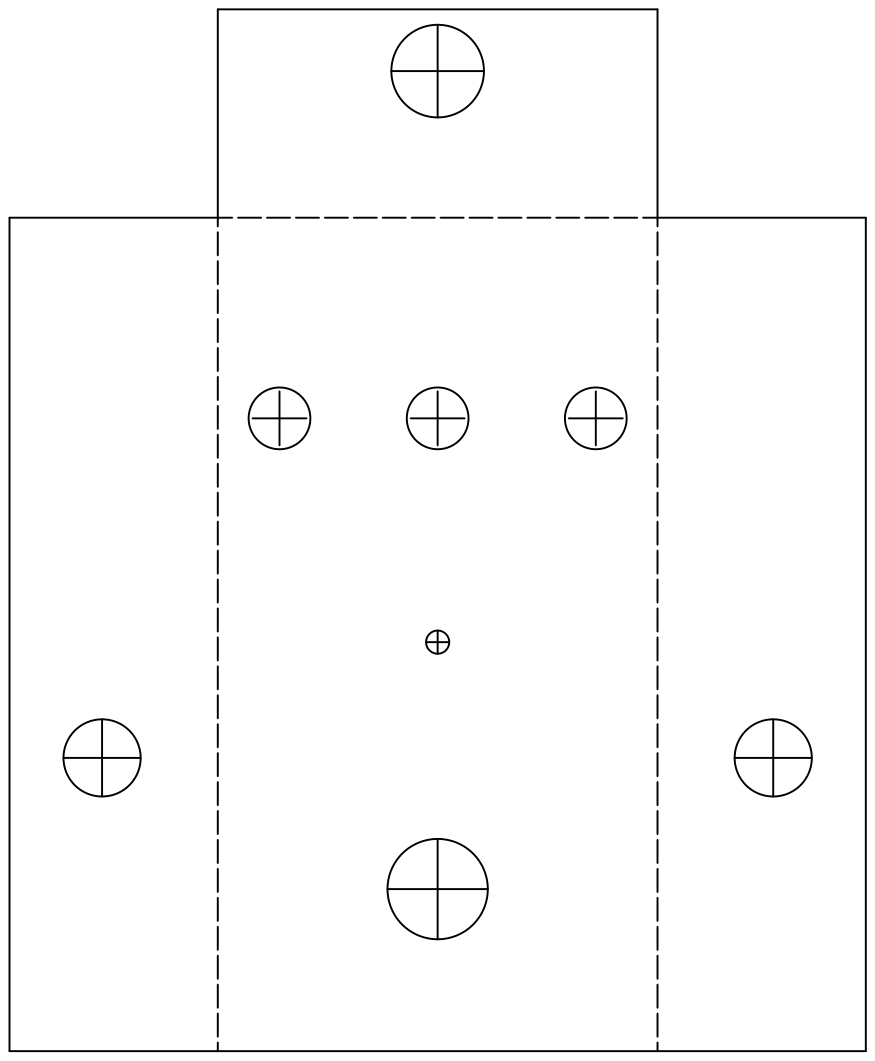
[picture p69: page 1]
