ExquisiteCatBread/RatDistortion/Drill template/RAT distortion drill template.pdf

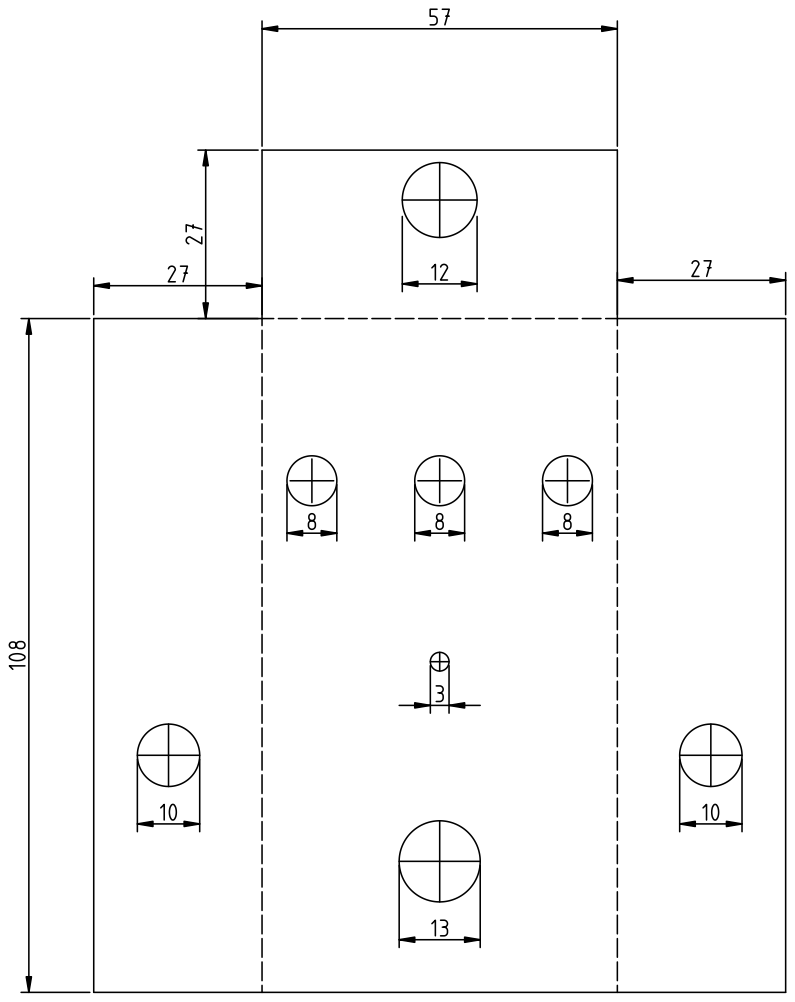
[picture p70: page 1]
