ExquisiteCatBread/RatDistortion/distortion sim.asc

C1: cap; 2.2µ
C2: cap; 4.7µ
C3: cap; 100p
C4: cap; 4.7µ
C5: cap; 22n
C6: cap; 1n
C7: cap; 3.3n
C8: cap; 22n
C9: cap; 1µ
D1: diode; 1N914
D2: diode; 1N914
J1: njf; 2N5485
R1: res; 47
R2: res; 560
R3: res; 0
R4: res; 100k
R5: res; 1000
R6: res; 1000
R7: res; 1000000
R8: res; 1000000
R9: res; 1000000
R10: res; 10000
R11: res; 70k
R12: res; 30k
R13: res; 10000
U1: OP07
V1: voltage; 9
V2: voltage; 4.5
V3: voltage; SINE(0 40m 330)
V4: voltage; 9
Named nets: 0, Vin, Vout
.tran 0.1
low pass filter stage
Output amp
Distortion circuit
dis pot (100k)
filter pot (100k)
vol pot (100k)
