ExquisiteCatBread/RatDistortion/Simulation (LTspice)/distortion sim.asc

C1: cap; 2.2µ
C2: cap; 4.7µ
C3: cap; 100p
C4: cap; 4.7µ
C5: cap; 22n
C6: cap; 1n
C7: cap; 3.3n
C8: cap; 22n
C9: cap; 1µ
D1: diode; 1N914
D2: diode; 1N914
J1: njf; 2N5458
J2: njf; 2N5458
Q1: npn
R1: res; 47
R2: res; 560
R3: res; 0
R4: res; 100k
R5: res; 1000
R6: res; 1000
R7: res; 1000000
R8: res; 1000000
R9: res; 1000000
R10: res; 10000
R11: res; 0
R12: res; 100k
R13: res; 10000
R14: res; 1.5k
R15: res; 10k
R16: res; 10k
U1: OP07
V1: voltage; 9
V2: voltage; 4.5
V3: voltage; SINE(0 400m 330)
V4: voltage; 9
V5: voltage; 9
V6: voltage; SINE(0 400m 330)
V7: voltage; 9
V8: voltage; SINE(0 400m 330)
Named nets: 0, Vin, Vout
.tran 0.01
low pass filter stage
Output amp
Distortion circuit
R4 dis pot (100k)
R3 filter pot (100k)
R11+R12 vol pot (100k)
Guitar in
Load
.model 2N5458  NJF(Vto=-2.882 Beta=488.9u Lambda=3.167m Rd=1 Rs=1 Cgs=4.627p Cgd=4p Pb=.5 Is=181.3f Kf=4.284E-18 Af=1 Fc=.5)
Test JFET
as expected
Test BJT
As seen in testing
Looks like received JFET is a NPN
Fake 2N5458
