ExquisiteCatBread/RatDistortion/PCB (Eagle)/RatDistortion.brd

## EAGLE design PCB (Eagle)/RatDistortion.brd (2021-12-15)

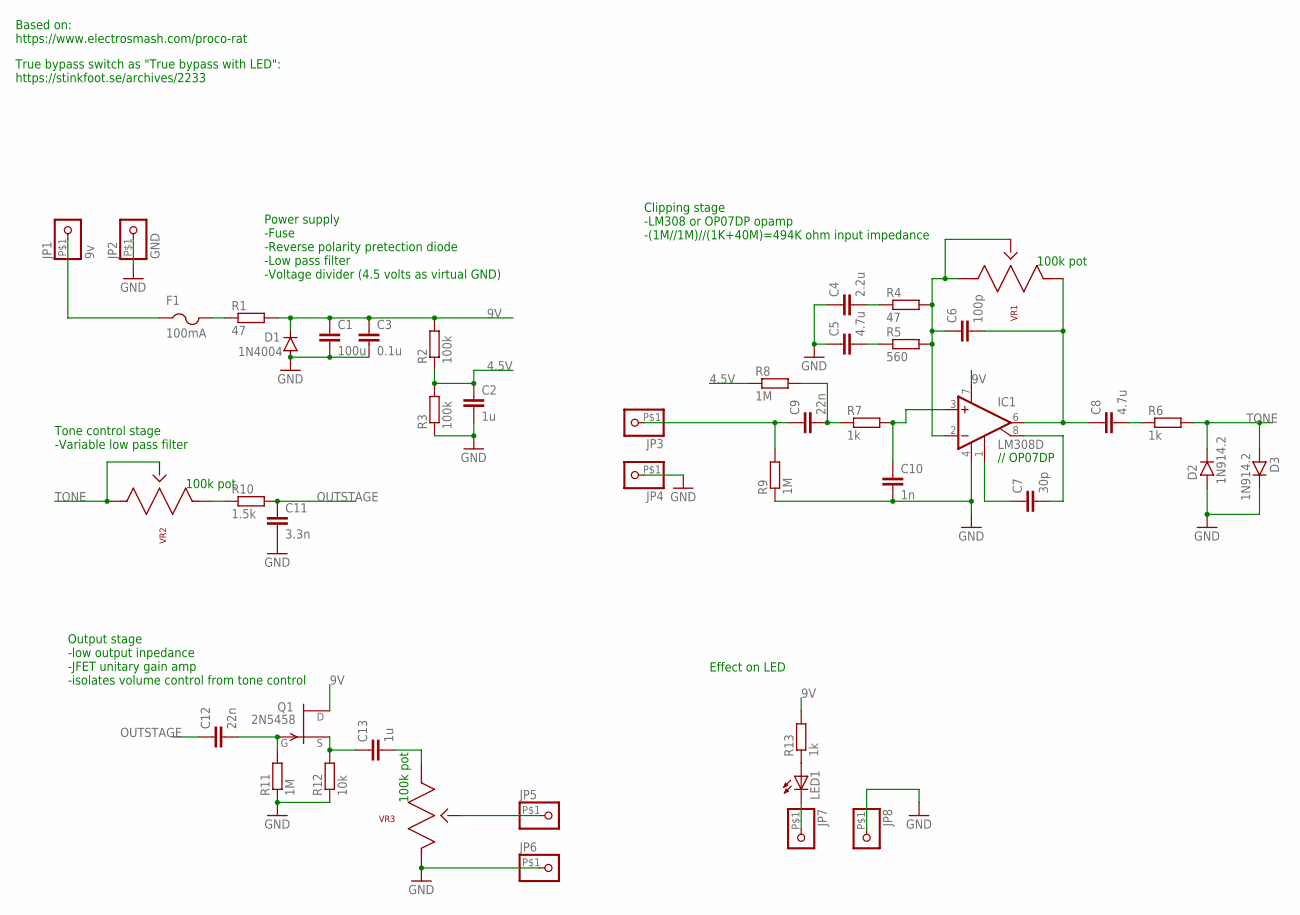
[picture p71: schematic RatDistortion.sch]

Parts:
C1: 100u; C1206
C2, C13: 1u; C1206
C3: 0.1u; C0603
C4: 2.2u; C1206
C5, C8: 4.7u; C1206
C6: 100p; C0603
C7: 30p; C0603
C9, C12: 22n; C0603
C10: 1n; C0603
C11: 3.3n; C0603
D1: 1N4004; DO41-10
D2, D3: 1N914.2; DO35-2
F1: 100mA; 1812
IC1: LM308D; SO08
JP1: 9v; 1X1-BIGPOGO
JP2: GND; 1X1-BIGPOGO
JP3, JP4, JP5, JP6, JP7, JP8: PINHD-1X1-BIGPOGO; 1X1-BIGPOGO
LED1: LED3MM
Q1: 2N5458; TO92
R1, R4: 47; R0603
R2, R3: 100k; R0603
R5: 560; R0603
R6, R7, R13: 1k; R0603
R8, R9, R11: 1M; R0603
R10: 1.5k; R0603
R12: 10k; R0603
VR1, VR2, VR3: PTV09A-4225F-B104; PTV09

Connections:
4.5V: C2.1, R2.1, R3.2, R8.1
9V: C1.1, C3.1, D1.C, IC1.7 (V+), Q1.3 (D), R1.2, R2.2, R13.2
GND: C1.2, C2.2, C3.2, C4.1, C5.1, C10.2, C11.2, D1.A, D2.A, D3.C, IC1.4 (V-), JP2.P$1, JP4.P$1, JP6.P$1, JP8.P$1, R3.1, R9.1, R11.1, R12.1, VR3.1
unnamed: F1.2, R1.1
unnamed: F1.1, JP1.P$1
unnamed: C4.2, R4.1
unnamed: C5.2, R5.1
unnamed: C6.1, IC1.2 (-IN), R4.2, R5.2, VR1.2, VR1.3
unnamed: C6.2, C8.1, IC1.6 (OUT), VR1.1
unnamed: C8.2, R6.1
unnamed: C12.2, Q1.1 (G), R11.2
unnamed: C7.1, IC1.1 (CMP1)
unnamed: C7.2, IC1.8 (CMP2)
unnamed: C13.1, Q1.2 (S), R12.2
unnamed: C10.1, IC1.3 (+IN), R7.2
unnamed: C9.2, R7.1, R8.2
unnamed: C9.1, JP3.P$1, R9.2
unnamed: R10.1, VR2.1
unnamed: C13.2, VR3.3
unnamed: LED1.A, R13.1
unnamed: JP5.P$1, VR3.2
unnamed: JP7.P$1, LED1.K (C)
OUTSTAGE: C11.1, C12.1, R10.2
TONE: D2.C, D3.A, R6.2, VR2.2, VR2.3

Notes on the sheet:
Power supply -Fuse -Reverse polarity pretection diode -Low pass filter -Voltage divider (4.5 volts as virtual GND)
100k pot
Clipping stage -LM308 or OP07DP opamp -(1M//1M)//(1K+40M)=494K ohm input impedance
Based on: https://www.electrosmash.com/proco-rat
// OP07DP
Tone control stage -Variable low pass filter
Output stage -low output inpedance -JFET unitary gain amp -isolates volume control from tone control
Effect on LED
True bypass switch as "True bypass with LED": https://stinkfoot.se/archives/2233

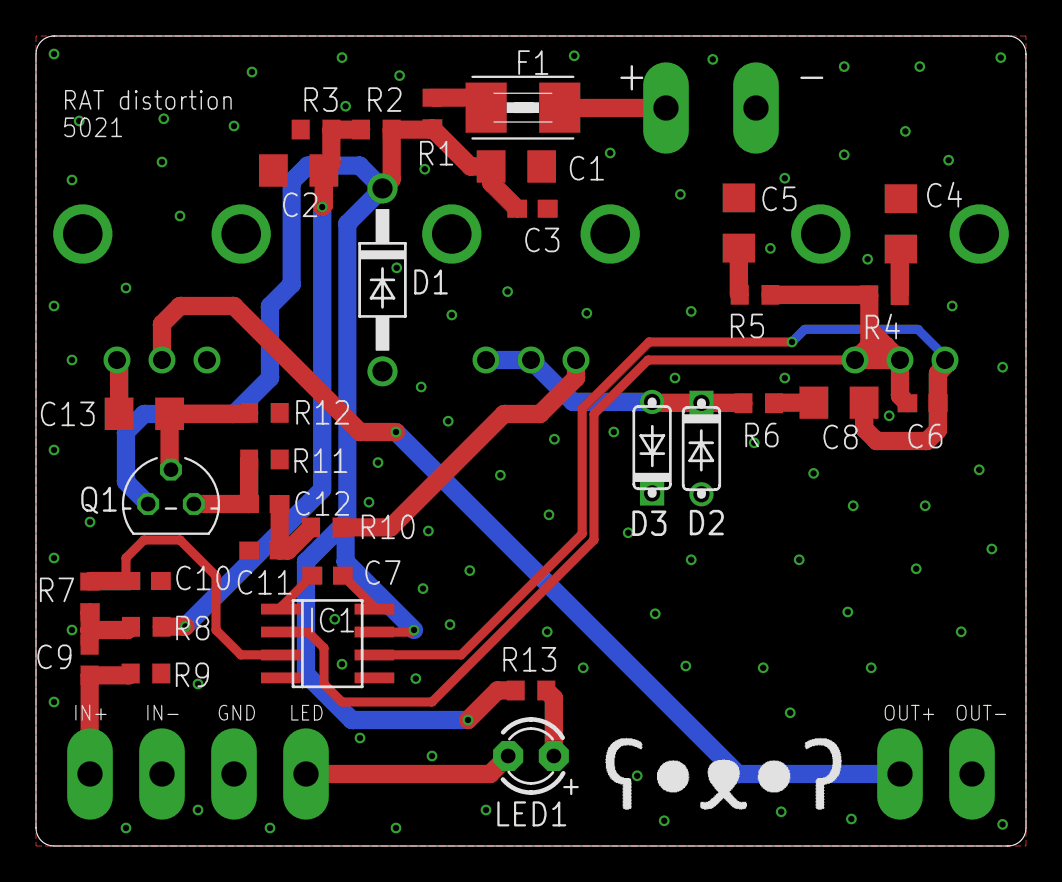
[picture p72: board RatDistortion.brd from above]

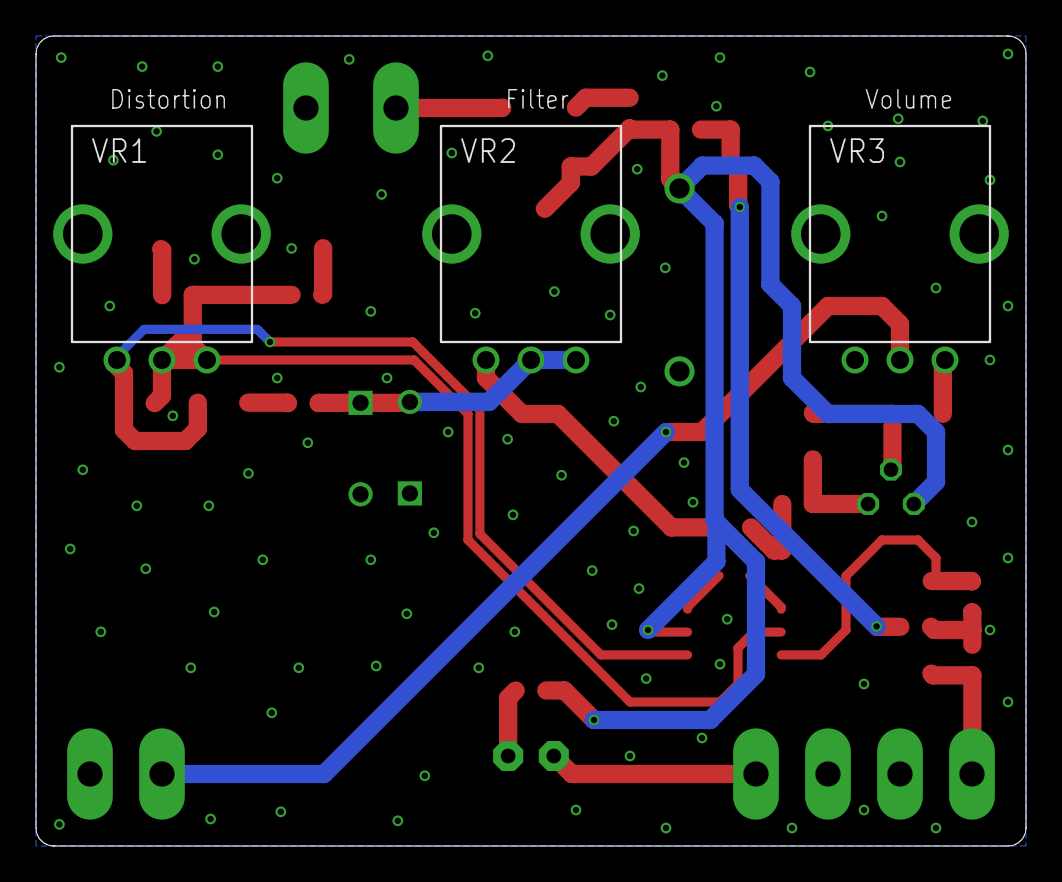
[picture p73: board RatDistortion.brd from below]

Board: 2 copper layers, 55.0 x 45.0 mm, 44 parts (4 on the bottom side), 24 nets.
