ExquisiteCatBread/RatDistortion/(commit log)

2021-12-11 Update schemetic
    [RatDistortion.brd, RatDistortion.sch]
2021-12-11 Schemetic and PCB
    [RatDistortion.brd, RatDistortion.sch]
2021-12-12 Cleaning, draft doc
    Cleaned folder structure
    Cleaned simulation drawing
    Added documentation draft
    [RatDistortion.brd, RatDistortion.sch]
2021-12-12 Delete 696103201002.lbr
    Removed unused fuse holder lib
2021-12-14 Updated Eagle files
    JFET 2N5458 (Q1 (was JN1)) in schematic is now correct icon (used default J201 device (same package and pinout)
    Updated PCB to Q1 and made values more readable for documentation (Value will probably not be printed on Silk layer)
    [RatDistortion.brd, RatDistortion.sch]
2021-12-14 Moved Q1 to own lib Eagle files
    [RatDistortion.brd, RatDistortion.sch]
2021-12-15 Updated sim (R14 was missing), picture for pcb
2021-12-15 Update PCB
    [RatDistortion.brd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]
2021-12-15 Updated silk screen error and doc
    PCB as ordered
    Removed LTSpice draft (was in wrong project folder)
    [RatDistortion.brd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]
2021-12-29 Update doc and simulation
    Made progress on realisation.
    2N5458 JFET seems to be fake and measures as a NPN transistor.
    Made a simulation in the SPICE file to replicate and confirm this.
    Updated doc with temporarily photos and updated price and order list (ordered new JFETS)
    Also added a WIP drill template. (NOT FINAL)
2021-12-30 Updated drill template
    [RAT distortion drill template.dxf]
2021-12-30 Update RAT distortion drill template.dxf
    [RAT distortion drill template.dxf]
2021-12-30 Adjusted drill template after first prototype
    [RAT distortion drill template.dxf]
2022-01-29 First completed version
    Added tests, wire schematic and more photos.
2023-10-08 Photos
    Photos of laser engraving
